eric5512/FreeEEG/Electronics/bom.xls

JLCPCB BOM Tool - BOM Matching
BOM name：bom-JLCPCB Assembly Order.xlsx |  |  | Download Time：2026-04-22 14:54:59 |  |  |  | * Our matching results are updated in real-time, but stock and prices may change. If it's been over 24 hours, please re-match before placing your order.
PCB Assembled Qty：5 |  |  | Est. Total Price：171.8839
Your BOM |  |  |  |  | Matched Parts |  |  |  |  |  |  | Order Information
Top Designator | Bottom Designator | Comment | Footprint | JLCPCB Part # | Matches | Part # | Manufacturer | Footprint | Description | Category | Warning | JLCPCB Part # | Product link | Lib Type | Qty | Source | Total Price ($)
C1,C31,C5 |  | 10u | 0805 |  | Select by System | GRM21BR61H106KE43L | Murata Electronics | 0805 | 10uF 50V X5R ±10% 0805 Multilayer Ceramic Capacitors MLCC - SMD/SMT ROHS | Multilayer Ceramic Capacitors MLCC - SMD/SMT |  | C440198 | https://jlcpcb.com/partdetail/439567-GRM21BR61H106KE43L/C440198 | Basic | 10 | 10 JLCPCB | 0.681
C2 |  | 10n | 0805 |  | Select by System | CL21B103KBANNNC | Samsung Electro-Mechanics | 0805 | 10nF 50V X7R ±10% 0805 Multilayer Ceramic Capacitors MLCC - SMD/SMT ROHS | Multilayer Ceramic Capacitors MLCC - SMD/SMT |  | C1710 | https://jlcpcb.com/partdetail/2062-CL21B103KBANNNC/C1710 | Basic | 20 | 20 JLCPCB | 0.132
C4 |  | 100n | 0805 |  | Select by System | CC0805KRX7R9BB104 | YAGEO | 0805 | 100nF 50V X7R ±10% 0805 Multilayer Ceramic Capacitors MLCC - SMD/SMT ROHS | Multilayer Ceramic Capacitors MLCC - SMD/SMT |  | C49678 | https://jlcpcb.com/partdetail/YAGEO-CC0805KRX7R9BB104/C49678 | Basic | 20 | 20 JLCPCB | 0.1
C6 |  | 330u | SMD |  | Select by System | EEEFT1V331AP | PANASONIC | SMD | -55℃~+105℃ 2000hrs@105℃ 330uF 35V 80mΩ@100kHz 850mA@100kHz ±20% SMD Aluminum Electrolytic Capacitors - SMD ROHS | Aluminum Electrolytic Capacitors - SMD |  | C178598 | https://jlcpcb.com/partdetail/PANASONIC-EEEFT1V331AP/C178598 | Extended | 5 | 5 JLCPCB | 2.597
C7 |  | 470u | SMD |  | Select by System | EEEFT1E471GP | PANASONIC | SMD | -55℃~+105℃ 25V 470uF 5000hrs@105℃ 80mΩ@100kHz 850mA@100kHz ±20% SMD Aluminum Electrolytic Capacitors - SMD ROHS | Aluminum Electrolytic Capacitors - SMD |  | C193277 | https://jlcpcb.com/partdetail/PANASONIC-EEEFT1E471GP/C193277 | Extended | 2 | 2 JLCPCB | 1.2656
C10,C11,C12,C13,C14,C15,C16,C17,C18,C19,C20,C21,C22,C23,C24,C8,C9 |  | 4.7n | 0603 |  | Select by System | GRM1885C1H472JA01D | Murata Electronics | 0603 | 4.7nF 50V C0G ±5% 0603 Multilayer Ceramic Capacitors MLCC - SMD/SMT ROHS | Multilayer Ceramic Capacitors MLCC - SMD/SMT |  | C85980 | https://jlcpcb.com/partdetail/MurataElectronics-GRM1885C1H472JA01D/C85980 | Extended | 44 | 44 JLCPCB | 0.594
C25,C26,C27,C3 |  | 1u | 0805 |  | Select by System | CL21B105KBFNNNE | Samsung Electro-Mechanics | 0805 | 1uF 50V X7R ±10% 0805 Multilayer Ceramic Capacitors MLCC - SMD/SMT ROHS | Multilayer Ceramic Capacitors MLCC - SMD/SMT |  | C28323 | https://jlcpcb.com/partdetail/29074-CL21B105KBFNNNE/C28323 | Basic | 20 | 20 JLCPCB | 0.266
C28,C29 |  | 33u | 1206 |  | Select by System | C3216X5R1E336MT000E | TDK | 1206 | 25V 33uF X5R ±20% 1206 Multilayer Ceramic Capacitors MLCC - SMD/SMT ROHS | Multilayer Ceramic Capacitors MLCC - SMD/SMT |  | C342307 | https://jlcpcb.com/partdetail/TDK-C3216X5R1E336MT000E/C342307 | Extended | 4 | 4 JLCPCB | 2.1988
C30,C46 |  | 10n | 0603 |  | Select by System | 0603B103K500NT | FH (Guangdong Fenghua Advanced Tech) | 0603 | 10nF 50V X7R ±10% 0603 Multilayer Ceramic Capacitors MLCC - SMD/SMT ROHS | Multilayer Ceramic Capacitors MLCC - SMD/SMT |  | C57112 | https://jlcpcb.com/partdetail/58143-0603B103K500NT/C57112 | Basic | 20 | 20 JLCPCB | 0.06
C32,C36,C39,C41,C43,C45 |  | 0.1u | 0603 |  | Unconfirmed | CC0603KRX7R9BB104 | YAGEO | 0603 | 100nF 50V X7R ±10% 0603 Multilayer Ceramic Capacitors MLCC - SMD/SMT ROHS | Multilayer Ceramic Capacitors MLCC - SMD/SMT | 1.Multiple lines in the BOM have been matched to the same part. Please check if the matching is correct. ; | C14663 | https://jlcpcb.com/partdetail/YAGEO-CC0603KRX7R9BB104/C14663 | Basic | 24 | 24 JLCPCB | 0.0792
C47 |  | 100n | 0603 |  | Unconfirmed | CC0603KRX7R9BB104 | YAGEO | 0603 | 100nF 50V X7R ±10% 0603 Multilayer Ceramic Capacitors MLCC - SMD/SMT ROHS | Multilayer Ceramic Capacitors MLCC - SMD/SMT | 1.Multiple lines in the BOM have been matched to the same part. Please check if the matching is correct. ; | C14663 | https://jlcpcb.com/partdetail/YAGEO-CC0603KRX7R9BB104/C14663 | Basic | 24 | 24 JLCPCB | 0.0792
C33 |  | 100u | SMD,D6.3xL7.7mm |  | Select by System | RVT1V101M0607 | Honor Elec | SMD,D6.3xL7.7mm | -55℃~+105℃ 100uF 2000hrs@105℃ 35V 6.3mm 7.7mm ±20% SMD,D6.3xL7.7mm Aluminum Electrolytic Capacitors - SMD ROHS | Aluminum Electrolytic Capacitors - SMD |  | C3339 | https://jlcpcb.com/partdetail/HonorElec-RVT1V101M0607/C3339 | Extended | 5 | 5 JLCPCB | 0.188
C34,C35,C37,C38,C40,C42,C44 |  | 1u | 0603 |  | Select by System | CL10A105KB8NNNC | Samsung Electro-Mechanics | 0603 | 1uF 50V X5R ±10% 0603 Multilayer Ceramic Capacitors MLCC - SMD/SMT ROHS | Multilayer Ceramic Capacitors MLCC - SMD/SMT |  | C15849 | https://jlcpcb.com/partdetail/16531-CL10A105KB8NNNC/C15849 | Basic | 24 | 24 JLCPCB | 0.1872
C48 |  | 2.2n | 0603 |  | Select by System | 0603B222K500NT | FH (Guangdong Fenghua Advanced Tech) | 0603 | 2.2nF 50V X7R ±10% 0603 Multilayer Ceramic Capacitors MLCC - SMD/SMT ROHS | Multilayer Ceramic Capacitors MLCC - SMD/SMT |  | C1604 | https://jlcpcb.com/partdetail/1956-0603B222K500NT/C1604 | Basic | 20 | 20 JLCPCB | 0.062
D1 |  | ON_LED | 0805 |  | Select by System | NCD0805R1 | Foshan NationStar Optoelectronics | 0805 | -30℃~+85℃ 1.6V~2.6V 130° 195mcd 25mA 615nm~630nm 630nm 65mW Discrete Diode Red 0805 LED Indication - Discrete ROHS | LED Indication - Discrete |  | C84256 | https://jlcpcb.com/partdetail/85425-NCD0805R1/C84256 | Basic | 20 | 20 JLCPCB | 0.266
D2 |  | SS54B | SMB |  | Select by System | SS54B | hongjiacheng | SMB | -55℃~+125℃ 120A 200uA@40V 40V 550mV@5A 5A Independent SMB Schottky Diodes ROHS | Schottky Diodes |  | C18199181 | https://jlcpcb.com/partdetail/hongjiacheng-SS54B/C18199181 | Extended | 5 | 5 JLCPCB | 0.328
D3 |  | LED_RAGB | SMD3528-4P |  | Select by System | XL-3528RGBW-HM | XINGLIGHT | SMD3528-4P | -20℃~+85℃ 1.9mm 120° 2.8mm 3.5mm B:460nm~475nm、G:515nm~530nm、R:620nm~630nm Common Anode G:400mcd~600mcd、B:120mcd~180mcd、R:150mcd~200mcd R:1.8V~2.2V、G:2.9V~3.2V、B:3.0V~3.3V R:2000V、G:2000V、B:2000V R:20mA、G:20mA、B:20mA R:50mW、G:70mW、B:70mW R:625nm、B:465nm、G:525nm Top-mount SMD3528-4P RGB LEDs ROHS | RGB LEDs |  | C2843813 | https://jlcpcb.com/partdetail/XINGLIGHT-XL_3528RGBWHM/C2843813 | Extended | 10 | 10 JLCPCB | 0.344
J2 |  | 10137065-00021LF | SMD |  | Select by System | 10137065-00021LF | Amphenol ICC | SMD | -55℃~+85℃ 1 24P Black Female Surface Mount, Right Angle Type-C SMD USB Connectors ROHS | Others |  | C5417177 | https://jlcpcb.com/partdetail/AmphenolICC-1013706500021LF/C5417177 | Extended | 2 | 2 JLCPCB | 7.456
L1 |  | 47u | SMD |  | Select by Customer | CYA0650-47UH | SHOU HAN | SMD,7.2x6.6mm | 2.8A 250mΩ 2A 47uH ±20% SMD,7.2x6.6mm Inductors (SMD) ROHS | Inductors (SMD) |  | C5189938 | https://jlcpcb.com/partdetail/SHOUHAN-CYA065047UH/C5189938 | Extended | 5 | 5 JLCPCB | 1.455
MICRO_SD1 |  | TF-01A | SMD |  | Select by System | TF-01A | Korean Hroparts Elec | SMD | 1.85mm Connector and Ejector MicroSD Card (TF Card) Push-Push With Locating Pins SMD SD Card / Memory Card Connector ROHS | SD Card / Memory Card Connector |  | C91145 | https://jlcpcb.com/partdetail/Korean_HropartsElec-TF01A/C91145 | Extended | 2 | 2 JLCPCB | 0.3772
Q1,Q2,Q3 |  | 2N7002 | SOT-23 |  | Select by System | 2N7002 | Jiangsu Changjing Electronics Technology Co., Ltd. | SOT-23 | 1 N-channel 115mA 2.5V 225mW 50pF 5pF 5Ω@10V 60V SOT-23 MOSFETs ROHS | MOSFETs |  | C8545 | https://jlcpcb.com/partdetail/9040-2N7002/C8545 | Basic | 11 | 11 JLCPCB | 0.1463
R1,R12,R13,R2,R3,R35,R4,R45,R5 |  | 10k | 0603 |  | Select by System | 0603WAF1002T5E | UNI-ROYAL(Uniroyal Elec) | 0603 | -55℃~+155℃ 100mW 10kΩ 75V Thick Film Resistor ±1% ±100ppm/℃ 0603 Chip Resistor - Surface Mount ROHS | Chip Resistor - Surface Mount |  | C25804 | https://jlcpcb.com/partdetail/26547-0603WAF1002T5E/C25804 | Basic | 28 | 28 JLCPCB | 0.0392
R6,R7 |  | 5.1k | 0603 |  | Select by System | 0603WAF5101T5E | UNI-ROYAL(Uniroyal Elec) | 0603 | -55℃~+155℃ 100mW 5.1kΩ 75V Thick Film Resistor ±1% ±100ppm/℃ 0603 Chip Resistor - Surface Mount ROHS | Chip Resistor - Surface Mount |  | C23186 | https://jlcpcb.com/partdetail/23913-0603WAF5101T5E/C23186 | Basic | 20 | 20 JLCPCB | 0.032
R10,R11,R34,R8,R9 |  | 33k | 0603 |  | Select by System | 0603WAF3302T5E | UNI-ROYAL(Uniroyal Elec) | 0603 | -55℃~+155℃ 100mW 33kΩ 75V Thick Film Resistor ±1% ±100ppm/℃ 0603 Chip Resistor - Surface Mount ROHS | Chip Resistor - Surface Mount |  | C4216 | https://jlcpcb.com/partdetail/4623-0603WAF3302T5E/C4216 | Basic | 20 | 20 JLCPCB | 0.028
R14 |  | 400 | 0805 |  | Select by System | TR0805B400RP0525Z | Ever Ohms Tech | 0805 | -55℃~+155℃ 125mW 150V 400Ω Thin Film Resistor ±0.1% ±25ppm/℃ 0805 Chip Resistor - Surface Mount ROHS | Chip Resistor - Surface Mount |  | C153298 | https://jlcpcb.com/partdetail/Ever_OhmsTech-TR0805B400RP0525Z/C153298 | Extended | 20 | 20 JLCPCB | 0.636
R15,R16,R17,R18,R19,R20,R21,R22,R23,R24,R25,R26,R27,R28,R29,R30,R31,R46 |  | 4.99k | 0603 |  | Select by System | 0603WAF4991T5E | UNI-ROYAL(Uniroyal Elec) | 0603 | -55℃~+155℃ 100mW 4.99kΩ 75V Thick Film Resistor ±1% ±100ppm/℃ 0603 Chip Resistor - Surface Mount ROHS | Chip Resistor - Surface Mount |  | C23046 | https://jlcpcb.com/partdetail/23773-0603WAF4991T5E/C23046 | Basic | 46 | 46 JLCPCB | 0.0782
R32,R33,R37 |  | 2M | 0603 |  | Select by System | 0603WAF2004T5E | UNI-ROYAL(Uniroyal Elec) | 0603 | -55℃~+155℃ 100mW 2MΩ 75V Thick Film Resistor ±1% ±100ppm/℃ 0603 Chip Resistor - Surface Mount ROHS | Chip Resistor - Surface Mount |  | C22976 | https://jlcpcb.com/partdetail/23703-0603WAF2004T5E/C22976 | Basic | 20 | 20 JLCPCB | 0.034
R36 |  | 392k | 0603 |  | Select by System | RCA03392KFLF | HKR(Hong Kong Resistors) | 0603 | -55℃~+155℃ 100mW 392kΩ 75V Thick Film Resistor ±1% ±100ppm/℃ 0603 Chip Resistor - Surface Mount ROHS |  |  | C22369707 | https://jlcpcb.com/partdetail/23848738-RCA03392KFLF/C22369707 | Extended | 20 | 20 JLCPCB | 0.018
R38 |  | 1M | 0603 |  | Select by System | 0603WAF1004T5E | UNI-ROYAL(Uniroyal Elec) | 0603 | -55℃~+155℃ 100mW 1MΩ 75V Thick Film Resistor ±1% ±100ppm/℃ 0603 Chip Resistor - Surface Mount ROHS | Chip Resistor - Surface Mount |  | C22935 | https://jlcpcb.com/partdetail/23662-0603WAF1004T5E/C22935 | Basic | 20 | 20 JLCPCB | 0.03
R39 |  | 720 | 0805 |  | Select by System | 0805W8F7320T5E | UNI-ROYAL(Uniroyal Elec) | 0805 | -55℃~+155℃ 125mW 150V 732Ω Thick Film Resistor ±1% ±100ppm/℃ 0805 Chip Resistor - Surface Mount ROHS | Chip Resistor - Surface Mount |  | C37998 | https://jlcpcb.com/partdetail/38979-0805W8F7320T5E/C37998 | Extended | 20 | 20 JLCPCB | 0.042
R40,R41 |  | 610 | 0805 |  | Select by System | FRC0805F5900TS | FOJAN | 0805 | -55℃~+155℃ 125mW 150V 590Ω Thick Film Resistor ±1% ±100ppm/℃ 0805 Chip Resistor - Surface Mount ROHS | Chip Resistor - Surface Mount |  | C5713312 | https://jlcpcb.com/partdetail/FOJAN-FRC0805F5900TS/C5713312 | Extended | 20 | 20 JLCPCB | 0.038
R42,R43,R44 |  | 10 | 0603 |  | Select by System | 0603WAF100JT5E | UNI-ROYAL(Uniroyal Elec) | 0603 | -55℃~+155℃ 100mW 10Ω 75V Thick Film Resistor ±1% ±400ppm/℃ 0603 Chip Resistor - Surface Mount ROHS | Chip Resistor - Surface Mount |  | C22859 | https://jlcpcb.com/partdetail/23586-0603WAF100JT5E/C22859 | Basic | 20 | 20 JLCPCB | 0.038
SW1 |  | ON_SW | 插件,9x3.5mm |  | Unconfirmed | K3-1260D-L1 | Korean Hroparts Elec | 插件,9x3.5mm | -25℃~+80℃ 10000 times 3.5mm 3.5mm 300mA 6V 9mm Black PC Pin Rectangular Columnar SPDT 插件,9x3.5mm Slide Switches ROHS | Slide Switches | 1.Multiple lines in the BOM have been matched to the same part. Please check if the matching is correct. ; | C92657 | https://jlcpcb.com/partdetail/Korean_HropartsElec-K3_1260DL1/C92657 | Extended | 5 | 5 JLCPCB | 0.7715
SW2 |  | SEL_SW | 插件,9x3.5mm |  | Unconfirmed | K3-1260D-L1 | Korean Hroparts Elec | 插件,9x3.5mm | -25℃~+80℃ 10000 times 3.5mm 3.5mm 300mA 6V 9mm Black PC Pin Rectangular Columnar SPDT 插件,9x3.5mm Slide Switches ROHS | Slide Switches | 1.Multiple lines in the BOM have been matched to the same part. Please check if the matching is correct. ; | C92657 | https://jlcpcb.com/partdetail/Korean_HropartsElec-K3_1260DL1/C92657 | Extended | 5 | 5 JLCPCB | 0.7715
SW3 |  | RST_BTN | SMD-4P,5.2x5.2mm |  | Unconfirmed | K2-1187SQ-A4SW-06 | Korean Hroparts Elec | SMD-4P,5.2x5.2mm | -25℃~+85℃ 1.5mm 100,000 cycles 12V 2.5N 5.2mm 5.2mm 50mA Round Button SPST Surface Mount,Vertical SMD-4P,5.2x5.2mm Tactile Switches ROHS | Tactile Switches | 1.Multiple lines in the BOM have been matched to the same part. Please check if the matching is correct. ; | C92584 | https://jlcpcb.com/partdetail/Korean_HropartsElec-K2_1187SQ_A4SW06/C92584 | Extended | 4 | 4 JLCPCB | 0.2144
SW4 |  | BOOT_BTN | SMD-4P,5.2x5.2mm |  | Unconfirmed | K2-1187SQ-A4SW-06 | Korean Hroparts Elec | SMD-4P,5.2x5.2mm | -25℃~+85℃ 1.5mm 100,000 cycles 12V 2.5N 5.2mm 5.2mm 50mA Round Button SPST Surface Mount,Vertical SMD-4P,5.2x5.2mm Tactile Switches ROHS | Tactile Switches | 1.Multiple lines in the BOM have been matched to the same part. Please check if the matching is correct. ; | C92584 | https://jlcpcb.com/partdetail/Korean_HropartsElec-K2_1187SQ_A4SW06/C92584 | Extended | 4 | 4 JLCPCB | 0.2144
U1 |  | ADS1299 | TQFP-64(10x10) |  | Select by System | ADS1299IPAGR | Texas Instruments | TQFP-64(10x10) | -40℃~+85℃ 1.5MHz~2.048MHz、2.048MHz 121dB 16000Hz 16000Hz 20uA 24 35ppm/℃ 3ppm/℃ 4.5V 4.75V~5.25V SPI TQFP-64(10x10) Analog Front End (AFE) ROHS | Analog Front End (AFE) |  | C476817 | https://jlcpcb.com/partdetail/TexasInstruments-ADS1299IPAGR/C476817 | Extended | 2 | 2 JLCPCB | 115.9016
U2,U4 |  | OPA376xxDBV | SOT-23-5 |  | Select by System | OPA376AIDBVR | Texas Instruments | SOT-23-5 | -40℃~+125℃ 0.2pA 0.2pA 1 2.2V~5.5V 260nV/℃ 2V/us 30mA 5.5MHz 5uV 7.5nV/√Hz@1kHz 760uA 76dB Rail-to-Rail Input, Rail-to-Rail Output SOT-23-5 Precision Op Amps ROHS | Precision Op Amps |  | C42134 | https://jlcpcb.com/partdetail/TexasInstruments-OPA376AIDBVR/C42134 | Extended | 4 | 4 JLCPCB | 2.442
U3 |  | ESP32-S3-WROOM-1 | SMD,25.5x18mm |  | Select by System | ESP32-S3-WROOM-1-N16R8 | Espressif Systems | SMD,25.5x18mm | -103.5dBm -40℃~+65℃ 2.4GHz 20.5dBm 355mA 3V~3.6V 95mA ESP32-S3R8 On-board PCB Antenna UART、SPI、I2C、GPIO、I2S、USB SMD,25.5x18mm WiFi Modules ROHS | WiFi Modules |  | C2913202 | https://jlcpcb.com/partdetail/3198300-ESP32_S3_WROOM_1N16R8/C2913202 | Extended | 2 | 2 JLCPCB | 10.2492
U5 |  | XL1509-3.3 | SOP-8 |  | Select by System | XL1509-3.3 | UMW(Youtai Semiconductor Co., Ltd.) | SOP-8 | -40℃~+125℃@(TJ) 1 150kHz 2A 2mA 3.3V 4.5V~40V Buck Buck Built-in Fixed No SOP-8 DC-DC Converters ROHS | DC-DC Converters |  | C2681226 | https://jlcpcb.com/partdetail/2773702-XL1509_33/C2681226 | Extended | 2 | 2 JLCPCB | 0.5102
U6 |  | NCP1117-5.0_SOT223 | SOT-223 |  | Select by System | NCP1117IST50T3G | onsemi | SOT-223 | -40℃~+125℃@(Ta) 0.003%Vout 1 1.2V@(800mA) 1A 20V 5V 61dB@(120Hz) 6mA Fixed Over Current Protection、Over Temperature Protection、Thermal Shutdown Positive SOT-223 Voltage Regulators - Linear, Low Drop Out (LDO) Regulators ROHS | Voltage Regulators - Linear, Low Drop Out (LDO) Regulators |  | C2902120 | https://jlcpcb.com/partdetail/onsemi-NCP1117IST50T3G/C2902120 | Extended | 2 | 2 JLCPCB | 1.1506
U7 |  | MPU-6050 | QFN-24-EP(4x4) |  | Select by System | MPU-6050 | TDK InvenSense | QFN-24-EP(4x4) | -40℃~+85℃ 16bit 1KB 2.375V~3.46V 5uA Accelerometer Gyroscope I2C X,Y,Z X,Y,Z ±16g ±2000dps QFN-24-EP(4x4) Accelerometers ROHS | Accelerometers |  | C24112 | https://jlcpcb.com/partdetail/TDKInvenSense-MPU6050/C24112 | Extended | 2 | 2 JLCPCB | 19.7826
BT1 |  | 9V |  |  | No matches | No Part Selected
J1 |  | ConnElectrodes |  |  | No matches | No Part Selected
