eric5512/FreeEEG/electronics/production/bom-JLCPCB Assembly Order.xls

JLCPCB BOM Tool - BOM Matching
BOM name：bom-JLCPCB Assembly Order.xlsx |  |  | Download Time：2026-07-23 12:50:30 |  |  |  | * Our matching results are updated in real-time, but stock and prices may change. If it's been over 24 hours, please re-match before placing your order.
PCB Assembled Qty：5 |  |  | Est. Total Price：168.9733
Your BOM |  |  |  |  | Matched Parts |  |  |  |  |  |  | Order Information
Top Designator | Bottom Designator | Comment | Footprint | JLCPCB Part # | Matches | Part # | Manufacturer | Footprint | Description | Category | Warning | JLCPCB Part # | Product link | Lib Type | Qty | Source | Total Price ($)
C1,C5 | C31 | 10u | 0805 |  | Unconfirmed | GRM21BR61H106KE43L | Murata Electronics | 0805 | 10uF 50V X5R ±10% 0805 Multilayer Ceramic Capacitors MLCC - SMD/SMT ROHS | Multilayer Ceramic Capacitors MLCC - SMD/SMT | 1.The comment (GRM21BR61H106KE43L) of this part does not match the one (10u) provided in your BOM. Please confirm; | C440198 | https://jlcpcb.com/partdetail/439567-GRM21BR61H106KE43L/C440198 | Basic | 10 | 10 JLCPCB | 2.825
C2 |  | 10n | 0805 |  | Unconfirmed | CL21B103KBANNNC | Samsung Electro-Mechanics | 0805 | 10nF 50V X7R ±10% 0805 Multilayer Ceramic Capacitors MLCC - SMD/SMT ROHS | Multilayer Ceramic Capacitors MLCC - SMD/SMT | 1.The comment (CL21B103KBANNNC) of this part does not match the one (10n) provided in your BOM. Please confirm; | C1710 | https://jlcpcb.com/partdetail/2062-CL21B103KBANNNC/C1710 | Basic | 20 | 20 JLCPCB | 0.378
C4 |  | 100n | 0805 |  | Unconfirmed | CC0805KRX7R9BB104 | YAGEO | 0805 | 100nF 50V X7R ±10% 0805 Multilayer Ceramic Capacitors MLCC - SMD/SMT ROHS | Multilayer Ceramic Capacitors MLCC - SMD/SMT | 1.The comment (CC0805KRX7R9BB104) of this part does not match the one (100n) provided in your BOM. Please confirm; | C49678 | https://jlcpcb.com/partdetail/YAGEO-CC0805KRX7R9BB104/C49678 | Basic | 20 | 20 JLCPCB | 0.642
 | C24 | 4.7n | 0603 |  | Unconfirmed | 0603B472K500NT | FH (Guangdong Fenghua Advanced Tech) | 0603 | 4.7nF 50V X7R ±10% 0603 Multilayer Ceramic Capacitors MLCC - SMD/SMT ROHS | Multilayer Ceramic Capacitors MLCC - SMD/SMT | 1.The comment (0603B472K500NT) of this part does not match the one (4.7n) provided in your BOM. Please confirm; | C53987 | https://jlcpcb.com/partdetail/55004-0603B472K500NT/C53987 | Basic | 20 | 20 JLCPCB | 0.43
C26,C52 |  | 1u | 0402 |  | Unconfirmed | CL05A105KA5NQNC | Samsung Electro-Mechanics | 0402 | 1uF 25V X5R ±10% 0402 Multilayer Ceramic Capacitors MLCC - SMD/SMT ROHS | Multilayer Ceramic Capacitors MLCC - SMD/SMT | 1.The comment (CL05A105KA5NQNC) of this part does not match the one (1u) provided in your BOM. Please confirm; | C52923 | https://jlcpcb.com/partdetail/53938-CL05A105KA5NQNC/C52923 | Basic | 20 | 20 JLCPCB | 0.53
C27,C3 | C25 | 1u | 0805 |  | Unconfirmed | CL21B105KBFNNNE | Samsung Electro-Mechanics | 0805 | 1uF 50V X7R ±10% 0805 Multilayer Ceramic Capacitors MLCC - SMD/SMT ROHS | Multilayer Ceramic Capacitors MLCC - SMD/SMT | 1.The comment (CL21B105KBFNNNE) of this part does not match the one (1u) provided in your BOM. Please confirm; | C28323 | https://jlcpcb.com/partdetail/29074-CL21B105KBFNNNE/C28323 | Basic | 40 | 40 JLCPCB | 3.456
C28,C50,C51,C6,C7 |  | 10u | 0402 |  | Unconfirmed | CL05A106MQ5NUNC | Samsung Electro-Mechanics | 0402 | 10uF 6.3V X5R ±20% 0402 Multilayer Ceramic Capacitors MLCC - SMD/SMT ROHS | Multilayer Ceramic Capacitors MLCC - SMD/SMT | 1.The comment (CL05A106MQ5NUNC) of this part does not match the one (10u) provided in your BOM. Please confirm; | C15525 | https://jlcpcb.com/partdetail/16204-CL05A106MQ5NUNC/C15525 | Basic | 20 | 20 JLCPCB | 0.814
C29 |  | 4.7u | 0402 |  | Select by Customer | 0402C0G560J500NT | AIDE CAPACITOR | 0402 | 0402 Multilayer Ceramic Capacitors MLCC - SMD/SMT ROHS | Multilayer Ceramic Capacitors MLCC - SMD/SMT | 1.The comment (0402C0G560J500NT) of this part does not match the one (4.7u) provided in your BOM. Please confirm; | C48579244 | https://jlcpcb.com/partdetail/AIDECAPACITOR-0402C0G560J500NT/C48579244 | Extended | 20 | 20 JLCPCB | 0.028
 | C32,C36,C39,C41,C43,C45 | 0.1u | 0603 |  | Unconfirmed | CC0603KRX7R9BB104 | YAGEO | 0603 | 100nF 50V X7R ±10% 0603 Multilayer Ceramic Capacitors MLCC - SMD/SMT ROHS | Multilayer Ceramic Capacitors MLCC - SMD/SMT | 1.The comment (CC0603KRX7R9BB104) of this part does not match the one (0.1u) provided in your BOM. Please confirm; | C14663 | https://jlcpcb.com/partdetail/YAGEO-CC0603KRX7R9BB104/C14663 | Basic | 22 | 22 JLCPCB | 0.55
 | C33 | 100u | 1206 |  | Unconfirmed | CL31A107MQHNNNE | Samsung Electro-Mechanics | 1206 | 100uF 6.3V X5R ±20% 1206 Multilayer Ceramic Capacitors MLCC - SMD/SMT ROHS | Multilayer Ceramic Capacitors MLCC - SMD/SMT | 1.The comment (CL31A107MQHNNNE) of this part does not match the one (100u) provided in your BOM. Please confirm; | C15008 | https://jlcpcb.com/partdetail/15681-CL31A107MQHNNNE/C15008 | Basic | 6 | 6 JLCPCB | 1.761
C46,C47,C48 | C30 | 10n | 0603 |  | Unconfirmed | 0603B103K500NT | FH (Guangdong Fenghua Advanced Tech) | 0603 | 10nF 50V X7R ±10% 0603 Multilayer Ceramic Capacitors MLCC - SMD/SMT ROHS | Multilayer Ceramic Capacitors MLCC - SMD/SMT | 1.The comment (0603B103K500NT) of this part does not match the one (10n) provided in your BOM. Please confirm; | C57112 | https://jlcpcb.com/partdetail/58143-0603B103K500NT/C57112 | Basic | 40 | 40 JLCPCB | 0.136
C49 | C34,C35,C37,C38,C40,C42,C44 | 1u | 0603 |  | Unconfirmed | CL10A105KB8NNNC | Samsung Electro-Mechanics | 0603 | 1uF 50V X5R ±10% 0603 Multilayer Ceramic Capacitors MLCC - SMD/SMT ROHS | Multilayer Ceramic Capacitors MLCC - SMD/SMT | 1.The comment (CL10A105KB8NNNC) of this part does not match the one (1u) provided in your BOM. Please confirm; | C15849 | https://jlcpcb.com/partdetail/16531-CL10A105KB8NNNC/C15849 | Basic | 44 | 44 JLCPCB | 1.0428
D1 |  | LED_AMBAR | 0603 |  | Unconfirmed | XL-1608SURC-06 | XINGLIGHT | 0603 | -40℃~+85℃ 120° 2.3V 20mA 225mcd 50mW 620nm~630nm 625nm Discrete Diode Red Top-mount Water Clear 0603 LED Indication - Discrete ROHS | LED Indication - Discrete | 1.The comment (XL-1608SURC-06) of this part does not match the one (LED_AMBAR) provided in your BOM. Please confirm; | C965799 | https://jlcpcb.com/partdetail/XINGLIGHT-XL_1608SURC06/C965799 | Extended | 20 | 20 JLCPCB | 0.076
D2 |  | LED_BLUE | 0603 |  | Select by System | XL-1608UBC-04 | XINGLIGHT | 0603 | -40℃~+85℃ 120° 20mA 3.3V 300mcd 455nm~475nm 470nm 70mW Blue Discrete Diode Top-mount Water Clear 0603 LED Indication - Discrete ROHS | LED Indication - Discrete |  | C965807 | https://jlcpcb.com/partdetail/XINGLIGHT-XL_1608UBC04/C965807 | Extended | 20 | 20 JLCPCB | 0.086
D3 |  | WS2812B | LED_WS2812B_PLCC4_5.0x5.0mm_P3.2mm |  | Select by Customer | WS2812B-V5/W | Worldsemi | SMD5050-4P | -40℃~+65℃ 0.6mA 1.57mm 2kHz 5.4mm 5V 5mm 800Kbit/s B:465nm~475nm、R:620nm~630nm、G:515nm~525nm Built-in power-on reset circuit、Built-in power-on reset circuit、Integrated intelligent reverse connection protection function R:310mcd、G:780mcd、B:215mcd White Frosted Lens SMD5050-4P RGB LEDs(Built-in IC) ROHS | RGB LEDs(Built-In IC) | 1.The comment (WS2812B-V5/W) of this part does not match the one (WS2812B) provided in your BOM. Please confirm; | C2874885 | https://jlcpcb.com/partdetail/Worldsemi-WS2812B_V5W/C2874885 | Extended | 5 | 5 JLCPCB | 0.544
IC1 |  | ICM-42670-P | ICM42670P |  | Select by System | ICM-42670-P | TDK InvenSense | LGA-14(2.5x3) | -40℃~+85℃ 1.71V~3.6V 16bit 2.25KB 3.5uA Accelerometer Gyroscope SPI、I2C、I3C X,Y,Z X,Y,Z ±16g ±2000dps LGA-14(2.5x3) Accelerometers ROHS | Accelerometers |  | C3288646 | https://jlcpcb.com/partdetail/TDKInvenSense-ICM_42670P/C3288646 | Extended | 2 | 2 JLCPCB | 6.2906
IC2 |  | BQ25185DLHR | SON40P220X200X80-11N |  | Select by System | BQ25185DLHR | Texas Instruments | WSON-10-EP(2.2x2) | -40℃~+125℃ 1 1A 2.2V 3V~18V 4.4V 4uA Charging IC Lithium Battery、LiFePO4 Battery Support WSON-10-EP(2.2x2) Battery Management ROHS | Battery Management |  | C19725033 | https://jlcpcb.com/partdetail/TexasInstruments-BQ25185DLHR/C19725033 | Extended | 2 | 2 JLCPCB | 3.2228
J2 |  | 10137065-00021LF | AMPHENOL_10137065-00021LF |  | Select by System | 10137065-00021LF | Amphenol ICC | SMD | -55℃~+85℃ 1 24P Black Female Surface Mount, Right Angle Type-C SMD USB Connectors ROHS | Others |  | C5417177 | https://jlcpcb.com/partdetail/AmphenolICC-1013706500021LF/C5417177 | Extended | 2 | 2 JLCPCB | 6.9448
J5 |  | B2B-PH-SM4-TBT_LF | B2BPHSM4TBTLFSN |  | Select by Customer | B2B-PH-SM4-TBT(LF)(SN) | JST | SMD,P=2mm | -25℃~+85℃ 1 100V 1x2P 2 2A 2P 2mm 6.6mm 7.95mm 7mm Auxiliary Solder Pin Beige Copper alloy PA PH Surface Mount,Vertical Tin UL94V-0 SMD,P=2mm Wire To Board Connector ROHS | Wire To Board Connector |  | C265003 | https://jlcpcb.com/partdetail/JST-B2B_PH_SM4_TBT_LF_SN/C265003 | Extended | 5 | 5 JLCPCB | 2.264
J6 |  | ExtTrig | PinHeader_2x03_P2.54mm_Vertical_SMD |  | Select by Customer | 2.54-2*3P立贴针 | BOOMELE(Boom Precision Elec) | SMD,P=2.54mm,卧贴 | -55℃~+105℃ 2 2.54mm 2.54mm 2.5mm 3A 6P 6mm Black Brass Gold Pin Header Surface Mount,Vertical SMD,P=2.54mm,卧贴 Pin Headers ROHS | Pin Headers |  | C192301 | https://jlcpcb.com/partdetail/221272-2_54_2_3P/C192301 | Extended | 10 | 10 JLCPCB | 0.477
L1 |  | 1u | 1008 |  | Select by Customer | MLP2520S1R0MT0S1 | TDK | 1008 | 1.5A 1uH 85mΩ Multilayer inductor ±20% 1008 Inductors (SMD) ROHS | Inductors (SMD) |  | C76795 | https://jlcpcb.com/partdetail/TDK-MLP2520S1R0MT0S1/C76795 | Extended | 6 | 6 JLCPCB | 0.5718
L2 |  | 2.2u | PIS2D18LP |  | Select by Customer | PIS2D18LP-2R2M-T | EMTEK | SMD | 2.2uH 55mΩ 750mA Magnetic Shielded Inductor ±20% SMD Power Inductors ROHS | Power Inductors |  | C251730 | https://jlcpcb.com/partdetail/EMTEK-PIS2D18LP_2R2MT/C251730 | Extended | 5 | 5 JLCPCB | 1.1815
MICRO_SD1 |  | TF-01A | TF-01A |  | Select by System | TF-01A | Korean Hroparts Elec | SMD | 1.85mm Connector and Ejector MicroSD Card (TF Card) Push-Push With Locating Pins SMD SD Card / Memory Card Connector ROHS | SD Card / Memory Card Connector |  | C91145 | https://jlcpcb.com/partdetail/Korean_HropartsElec-TF01A/C91145 | Extended | 2 | 2 JLCPCB | 0.3804
MK1 |  | ICS-43434 | ICS43434 |  | Select by System | ICS-43434 | TDK InvenSense | LGA-6(3.5x2.7) | -26dB -40℃~+85℃ 0.98mm 1.65V~3.63V 2.65mm 3.5mm 550uA 64dB I2S Omnidirectional Omnidirectional pickup LGA-6(3.5x2.7) MEMS Microphones ROHS | MEMS Microphones |  | C5656610 | https://jlcpcb.com/partdetail/TDKInvenSense-ICS43434/C5656610 | Extended | 2 | 2 JLCPCB | 9.22
R1,R15,R2,R3,R35,R4,R40,R5 | R12,R13,R45 | 10k | 0603 |  | Unconfirmed | 0603WAF1002T5E | UNI-ROYAL(Uniroyal Elec) | 0603 | -55℃~+155℃ 100mW 10kΩ 75V Thick Film Resistor ±1% ±100ppm/℃ 0603 Chip Resistor - Surface Mount ROHS | Chip Resistor - Surface Mount | 1.The comment (0603WAF1002T5E) of this part does not match the one (10k) provided in your BOM. Please confirm; | C25804 | https://jlcpcb.com/partdetail/26547-0603WAF1002T5E/C25804 | Basic | 46 | 46 JLCPCB | 0.1104
R6,R7 |  | 5.1k | 0603 |  | Unconfirmed | 0603WAF5101T5E | UNI-ROYAL(Uniroyal Elec) | 0603 | -55℃~+155℃ 100mW 5.1kΩ 75V Thick Film Resistor ±1% ±100ppm/℃ 0603 Chip Resistor - Surface Mount ROHS | Chip Resistor - Surface Mount | 1.The comment (0603WAF5101T5E) of this part does not match the one (5.1k) provided in your BOM. Please confirm; | C23186 | https://jlcpcb.com/partdetail/23913-0603WAF5101T5E/C23186 | Basic | 20 | 20 JLCPCB | 0.056
 | R10,R11,R8,R9 | 33k | 0603 |  | Unconfirmed | 0603WAF3302T5E | UNI-ROYAL(Uniroyal Elec) | 0603 | -55℃~+155℃ 100mW 33kΩ 75V Thick Film Resistor ±1% ±100ppm/℃ 0603 Chip Resistor - Surface Mount ROHS | Chip Resistor - Surface Mount | 1.The comment (0603WAF3302T5E) of this part does not match the one (33k) provided in your BOM. Please confirm; | C4216 | https://jlcpcb.com/partdetail/4623-0603WAF3302T5E/C4216 | Basic | 20 | 20 JLCPCB | 0.042
R14 |  | 249k | 0603 |  | Unconfirmed | 0603WAF2493T5E | UNI-ROYAL(Uniroyal Elec) | 0603 | -55℃~+155℃ 100mW 249kΩ 75V Thick Film Resistor ±1% ±100ppm/℃ 0603 Chip Resistor - Surface Mount ROHS | Chip Resistor - Surface Mount | 1.The comment (0603WAF2493T5E) of this part does not match the one (249k) provided in your BOM. Please confirm; | C22918 | https://jlcpcb.com/partdetail/23645-0603WAF2493T5E/C22918 | Extended | 20 | 20 JLCPCB | 0.042
R16 |  | 13k | 0603 |  | Unconfirmed | 0603WAF1302T5E | UNI-ROYAL(Uniroyal Elec) | 0603 | -55℃~+155℃ 100mW 13kΩ 75V Thick Film Resistor ±1% ±100ppm/℃ 0603 Chip Resistor - Surface Mount ROHS | Chip Resistor - Surface Mount | 1.The comment (0603WAF1302T5E) of this part does not match the one (13k) provided in your BOM. Please confirm; | C22797 | https://jlcpcb.com/partdetail/23524-0603WAF1302T5E/C22797 | Basic | 20 | 20 JLCPCB | 0.122
R17 |  | 619 | 0603 |  | Unconfirmed | FRC0603F6190TS | FOJAN | 0603 | -55℃~+155℃ 100mW 619Ω 75V Thick Film Resistor ±1% ±100ppm/℃ 0603 Chip Resistor - Surface Mount ROHS | Chip Resistor - Surface Mount | 1.The comment (FRC0603F6190TS) of this part does not match the one (619) provided in your BOM. Please confirm; | C3013204 | https://jlcpcb.com/partdetail/FOJAN-FRC0603F6190TS/C3013204 | Extended | 20 | 20 JLCPCB | 0.048
R18 |  | 22k | 0603 |  | Unconfirmed | 0603WAF2202T5E | UNI-ROYAL(Uniroyal Elec) | 0603 | -55℃~+155℃ 100mW 22kΩ 75V Thick Film Resistor ±1% ±100ppm/℃ 0603 Chip Resistor - Surface Mount ROHS | Chip Resistor - Surface Mount | 1.The comment (0603WAF2202T5E) of this part does not match the one (22k) provided in your BOM. Please confirm; | C31850 | https://jlcpcb.com/partdetail/32812-0603WAF2202T5E/C31850 | Basic | 20 | 20 JLCPCB | 0.048
R19 |  | 150 | 0603 |  | Unconfirmed | 0603WAF1500T5E | UNI-ROYAL(Uniroyal Elec) | 0603 | -55℃~+155℃ 100mW 150Ω 75V Thick Film Resistor ±1% ±100ppm/℃ 0603 Chip Resistor - Surface Mount ROHS | Chip Resistor - Surface Mount | 1.The comment (0603WAF1500T5E) of this part does not match the one (150) provided in your BOM. Please confirm; | C22808 | https://jlcpcb.com/partdetail/23535-0603WAF1500T5E/C22808 | Basic | 20 | 20 JLCPCB | 0.216
R20 |  | 120 | 0603 |  | Unconfirmed | 0603WAF1200T5E | UNI-ROYAL(Uniroyal Elec) | 0603 | -55℃~+155℃ 100mW 120Ω 75V Thick Film Resistor ±1% ±100ppm/℃ 0603 Chip Resistor - Surface Mount ROHS | Chip Resistor - Surface Mount | 1.The comment (0603WAF1200T5E) of this part does not match the one (120) provided in your BOM. Please confirm; | C22787 | https://jlcpcb.com/partdetail/23514-0603WAF1200T5E/C22787 | Basic | 20 | 20 JLCPCB | 0.054
 | R31,R49 | 4.99k | 0603 |  | Unconfirmed | 0603WAF4991T5E | UNI-ROYAL(Uniroyal Elec) | 0603 | -55℃~+155℃ 100mW 4.99kΩ 75V Thick Film Resistor ±1% ±100ppm/℃ 0603 Chip Resistor - Surface Mount ROHS | Chip Resistor - Surface Mount | 1.The comment (0603WAF4991T5E) of this part does not match the one (4.99k) provided in your BOM. Please confirm; | C23046 | https://jlcpcb.com/partdetail/23773-0603WAF4991T5E/C23046 | Basic | 20 | 20 JLCPCB | 0.182
R34 |  | 50k | 0603 |  | Unconfirmed | RT0603BRD0750KL | YAGEO | 0603 | -55℃~+155℃ 100mW 50kΩ 75V Thin Film Resistor ±0.1% ±25ppm/℃ 0603 Chip Resistor - Surface Mount ROHS | Chip Resistor - Surface Mount | 1.The comment (RT0603BRD0750KL) of this part does not match the one (50k) provided in your BOM. Please confirm; | C861451 | https://jlcpcb.com/partdetail/YAGEO-RT0603BRD0750KL/C861451 | Extended | 20 | 20 JLCPCB | 0.648
 | R36 | 392k | 0603 |  | Unconfirmed | RCA03392KFLF | HKR(Hong Kong Resistors) | 0603 | -55℃~+155℃ 100mW 392kΩ 75V Thick Film Resistor ±1% ±100ppm/℃ 0603 Chip Resistor - Surface Mount ROHS |  | 1.The comment (RCA03392KFLF) of this part does not match the one (392k) provided in your BOM. Please confirm; | C22369707 | https://jlcpcb.com/partdetail/23848738-RCA03392KFLF/C22369707 | Extended | 20 | 20 JLCPCB | 0.03
R37,R38 |  | 2M | 0603 |  | Unconfirmed | 0603WAF2004T5E | UNI-ROYAL(Uniroyal Elec) | 0603 | -55℃~+155℃ 100mW 2MΩ 75V Thick Film Resistor ±1% ±100ppm/℃ 0603 Chip Resistor - Surface Mount ROHS | Chip Resistor - Surface Mount | 1.The comment (0603WAF2004T5E) of this part does not match the one (2M) provided in your BOM. Please confirm; | C22976 | https://jlcpcb.com/partdetail/23703-0603WAF2004T5E/C22976 | Basic | 20 | 20 JLCPCB | 0.056
R39 |  | 100k | 0603 |  | Unconfirmed | 0603WAF1003T5E | UNI-ROYAL(Uniroyal Elec) | 0603 | -55℃~+155℃ 100kΩ 100mW 75V Thick Film Resistor ±1% ±100ppm/℃ 0603 Chip Resistor - Surface Mount ROHS | Chip Resistor - Surface Mount | 1.The comment (0603WAF1003T5E) of this part does not match the one (100k) provided in your BOM. Please confirm; | C25803 | https://jlcpcb.com/partdetail/26546-0603WAF1003T5E/C25803 | Basic | 20 | 20 JLCPCB | 0.054
R47,R48 |  | 4.7k | 0603 |  | Unconfirmed | 0603WAF4701T5E | UNI-ROYAL(Uniroyal Elec) | 0603 | -55℃~+155℃ 100mW 4.7kΩ 75V Thick Film Resistor ±1% ±100ppm/℃ 0603 Chip Resistor - Surface Mount ROHS | Chip Resistor - Surface Mount | 1.The comment (0603WAF4701T5E) of this part does not match the one (4.7k) provided in your BOM. Please confirm; | C23162 | https://jlcpcb.com/partdetail/23889-0603WAF4701T5E/C23162 | Basic | 20 | 20 JLCPCB | 0.042
 | RN1,RN2,RN3,RN4 | R_Pack04_SIP_Split | 4D03WGF5101T5E |  | Select by Customer | 4D03WGF5101T5E | UNI-ROYAL(Uniroyal Elec) | 0603x4 | 1/16W 4 5.1kΩ 8 ±1% ±200ppm/℃ 0603x4 Resistor Networks, Arrays ROHS | Resistor Networks, Arrays |  | C425200 | https://jlcpcb.com/partdetail/418824-4D03WGF5101T5E/C425200 | Extended | 8 | 8 JLCPCB | 0.1008
SW1 |  | ON_SW | K3-1260D-L1 |  | Select by Customer | K3-1260D-L1 | Korean Hroparts Elec | 插件,9x3.5mm | -25℃~+80℃ 10000 times 3.5mm 3.5mm 300mA 6V 9mm Black PC Pin Rectangular Columnar SPDT 插件,9x3.5mm Slide Switches ROHS | Slide Switches | 1.Multiple lines in the BOM have been matched to the same part. Please check if the matching is correct. ; | C92657 | https://jlcpcb.com/partdetail/Korean_HropartsElec-K3_1260DL1/C92657 | Extended | 5 | 5 JLCPCB | 0.6655
SW2 |  | SEL_SW | K3-1260D-L1 |  | Select by Customer | K3-1260D-L1 | Korean Hroparts Elec | 插件,9x3.5mm | -25℃~+80℃ 10000 times 3.5mm 3.5mm 300mA 6V 9mm Black PC Pin Rectangular Columnar SPDT 插件,9x3.5mm Slide Switches ROHS | Slide Switches | 1.Multiple lines in the BOM have been matched to the same part. Please check if the matching is correct. ; | C92657 | https://jlcpcb.com/partdetail/Korean_HropartsElec-K3_1260DL1/C92657 | Extended | 5 | 5 JLCPCB | 0.6655
SW3 |  | RST_BTN | K2-1187SQ-A4SW-06 |  | Select by Customer | K2-1187SQ-A4SW-06 | Korean Hroparts Elec | SMD-4P,5.2x5.2mm | -25℃~+85℃ 1.5mm 100,000 cycles 12V 2.5N 5.2mm 5.2mm 50mA Round Button SPST Surface Mount,Vertical SMD-4P,5.2x5.2mm Tactile Switches ROHS | Tactile Switches |  | C92584 | https://jlcpcb.com/partdetail/Korean_HropartsElec-K2_1187SQ_A4SW06/C92584 | Extended | 2 | 2 JLCPCB | 0.108
 | U1 | ADS1299 | TQFP-64_10x10mm_P0.5mm |  | Unconfirmed | ADS1299IPAGR | Texas Instruments | TQFP-64(10x10) | -40℃~+85℃ 1.5MHz~2.048MHz、2.048MHz 121dB 16000Hz 16000Hz 20uA 24 4.5V 4.75V~5.25V 8 Programmable gain、Multiplexers、Internal reference source、Fault detection、Built-in temperature sensor、Simultaneous sampling control SPI TQFP-64(10x10) Analog Front End (AFE) ROHS | Analog Front End (AFE) | 1.The comment (ADS1299IPAGR) of this part does not match the one (ADS1299) provided in your BOM. Please confirm; | C476817 | https://jlcpcb.com/partdetail/TexasInstruments-ADS1299IPAGR/C476817 | Extended | 2 | 2 JLCPCB | 102.998
U3 |  | ESP32-S3-WROOM-1 | ESP32-S3-WROOM-1 |  | Unconfirmed | ESP32-S3-WROOM-1-N16R8 | Espressif Systems | SMD,25.5x18mm | -103.5dBm -40℃~+65℃ 2.4GHz 20.5dBm 355mA 3V~3.6V 95mA ESP32-S3R8 On-board PCB Antenna UART、SPI、I2C、GPIO、I2S、USB SMD,25.5x18mm WiFi Modules ROHS | WiFi Modules | 1.The comment (ESP32-S3-WROOM-1-N16R8) of this part does not match the one (ESP32-S3-WROOM-1) provided in your BOM. Please confirm; | C2913202 | https://jlcpcb.com/partdetail/3198300-ESP32_S3_WROOM_1N16R8/C2913202 | Extended | 2 | 2 JLCPCB | 10.9892
 | U4 | OPA376xxDBV | SOT-23-5 |  | Select by Customer | OPA376AIDBVR | Texas Instruments | SOT-23-5 | -40℃~+125℃ 0.2pA 0.2pA 1 2.2V~5.5V 260nV/℃ 2V/us 30mA 5.5MHz 5uV 7.5nV/√Hz@1kHz 760uA 76dB Rail-to-Rail Input, Rail-to-Rail Output SOT-23-5 Precision Op Amps ROHS | Precision Op Amps |  | C42134 | https://jlcpcb.com/partdetail/TexasInstruments-OPA376AIDBVR/C42134 | Extended | 2 | 2 JLCPCB | 3.9156
U7 |  | TPS610997YFFR | BGA6N40P3X2_122X88X62N |  | Select by System | TPS610997YFFR | Texas Instruments | DSBGA-6 | -40℃~+85℃ 1 1.1uA 300mA 5V 700mV~5.5V Boost Boost Built-in Fixed Yes DSBGA-6 DC-DC Converters ROHS | DC-DC Converters |  | C2072359 | https://jlcpcb.com/partdetail/TexasInstruments-TPS610997YFFR/C2072359 | Extended | 2 | 2 JLCPCB | 1.6824
U8 |  | TPS628438DRL | SOT-563 |  | Unconfirmed | TPS628438DRLR | Texas Instruments | SOT-563 | -40℃~+125℃ 1 1.8V~3.6V 275nA 5.5V 600mA Adjustable Positive Under Voltage Lockout、Over Current Protection、Over Temperature Protection、Soft Start、Enable SOT-563 DC-DC Converters ROHS | Voltage Regulators - Linear, Low Drop Out (LDO) Regulators | 1.The comment (TPS628438DRLR) of this part does not match the one (TPS628438DRL) provided in your BOM. Please confirm; | C38060243 | https://jlcpcb.com/partdetail/TexasInstruments-TPS628438DRLR/C38060243 | Extended | 2 | 2 JLCPCB | 2.2462
J1 |  | ConnElectrodes | PinHeader_2x10_P2.54mm_Vertical |  | No matches | No Part Selected
 | TP1 | REF_TEST | TestPoint_Pad_D1.5mm |  | No matches | No Part Selected
 | TP2 | GND_TEST | TestPoint_Pad_D1.5mm |  | No matches | No Part Selected
TP3 |  | 3V3_TEST | TestPoint_Pad_D1.5mm |  | No matches | No Part Selected
TP4 |  | 5V_TEST | TestPoint_Pad_D1.5mm |  | No matches | No Part Selected
