eric5512/FreeEEG/electronics/FreeEEG.kicad_pcb

## KiCad design electronics/FreeEEG.kicad_pcb (2026-10-01)

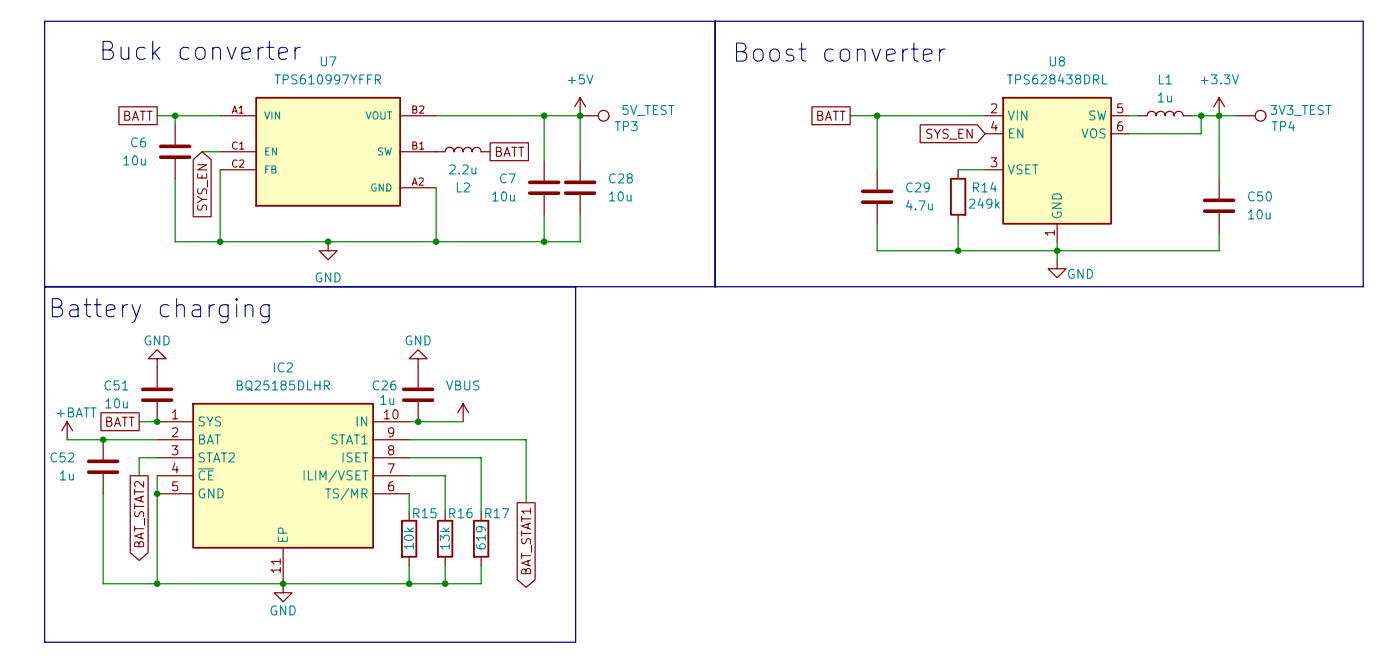
[picture p1: schematic power.kicad_sch]

Parts:
C6, C7, C28, C50, C51: 10u; C_0402_1005Metric
C26, C52: 1u; C_0402_1005Metric
C29: 4.7u; C_0402_1005Metric
IC2: BQ25185DLHR; SON40P220X200X80-11N; Manufacturer_Part_Number BQ25185DLHR; Mouser Part Number 595-BQ25185DLHR
L1: 1u; L_1008_2520Metric
L2: 2.2u; PIS2D18LP
R14: 249k; R_0603_1608Metric
R15: 10k; R_0603_1608Metric
R16: 13k; R_0603_1608Metric
R17: 619; R_0603_1608Metric
TP3: 5V_TEST; TestPoint_Pad_D1.5mm
TP4: 3V3_TEST; TestPoint_Pad_D1.5mm
U7: TPS610997YFFR; BGA6N40P3X2_122X88X62N; PARTREV K
U8: TPS628438DRL; SOT-563

Connections:
+3.3V: C50.1, L1.2, TP4.1 (1_1), U8.6 (VOS); also elsewhere on the board
+5V: C7.1, C28.1, TP3.1 (1_1), U7.B2 (VOUT); also elsewhere on the board
+BATT: C52.1, IC2.2 (BAT); also elsewhere on the board
BATT: C6.1, C29.1, C51.2, IC2.1 (SYS), L2.1, U7.A1 (VIN), U8.2 (VIN); also elsewhere on the board
BAT_STAT1: IC2.9 (STAT1); also elsewhere on the board
BAT_STAT2: IC2.3 (STAT2); also elsewhere on the board
GND: C6.2, C7.2, C26.1, C28.2, C29.2, C50.2, C51.1, C52.2, IC2.4 (~CE), IC2.5 (GND), IC2.11 (EP), R14.2, R15.2, R16.2, R17.2, U7.A2 (GND), U7.C2 (FB), U8.1 (GND); also elsewhere on the board
unnamed: IC2.7 (ILIM/VSET), R16.1
unnamed: IC2.8 (ISET), R17.1
unnamed: IC2.6 (TS/MR), R15.1
unnamed: L2.2, U7.B1 (SW)
unnamed: L1.1, U8.5 (SW)
unnamed: R14.1, U8.3 (VSET)
SYS_EN: U7.C1 (EN), U8.4 (EN); also elsewhere on the board
VBUS: C26.2, IC2.10 (IN); also elsewhere on the board

Notes on the sheet:
Battery charging
Buck converter
Boost converter

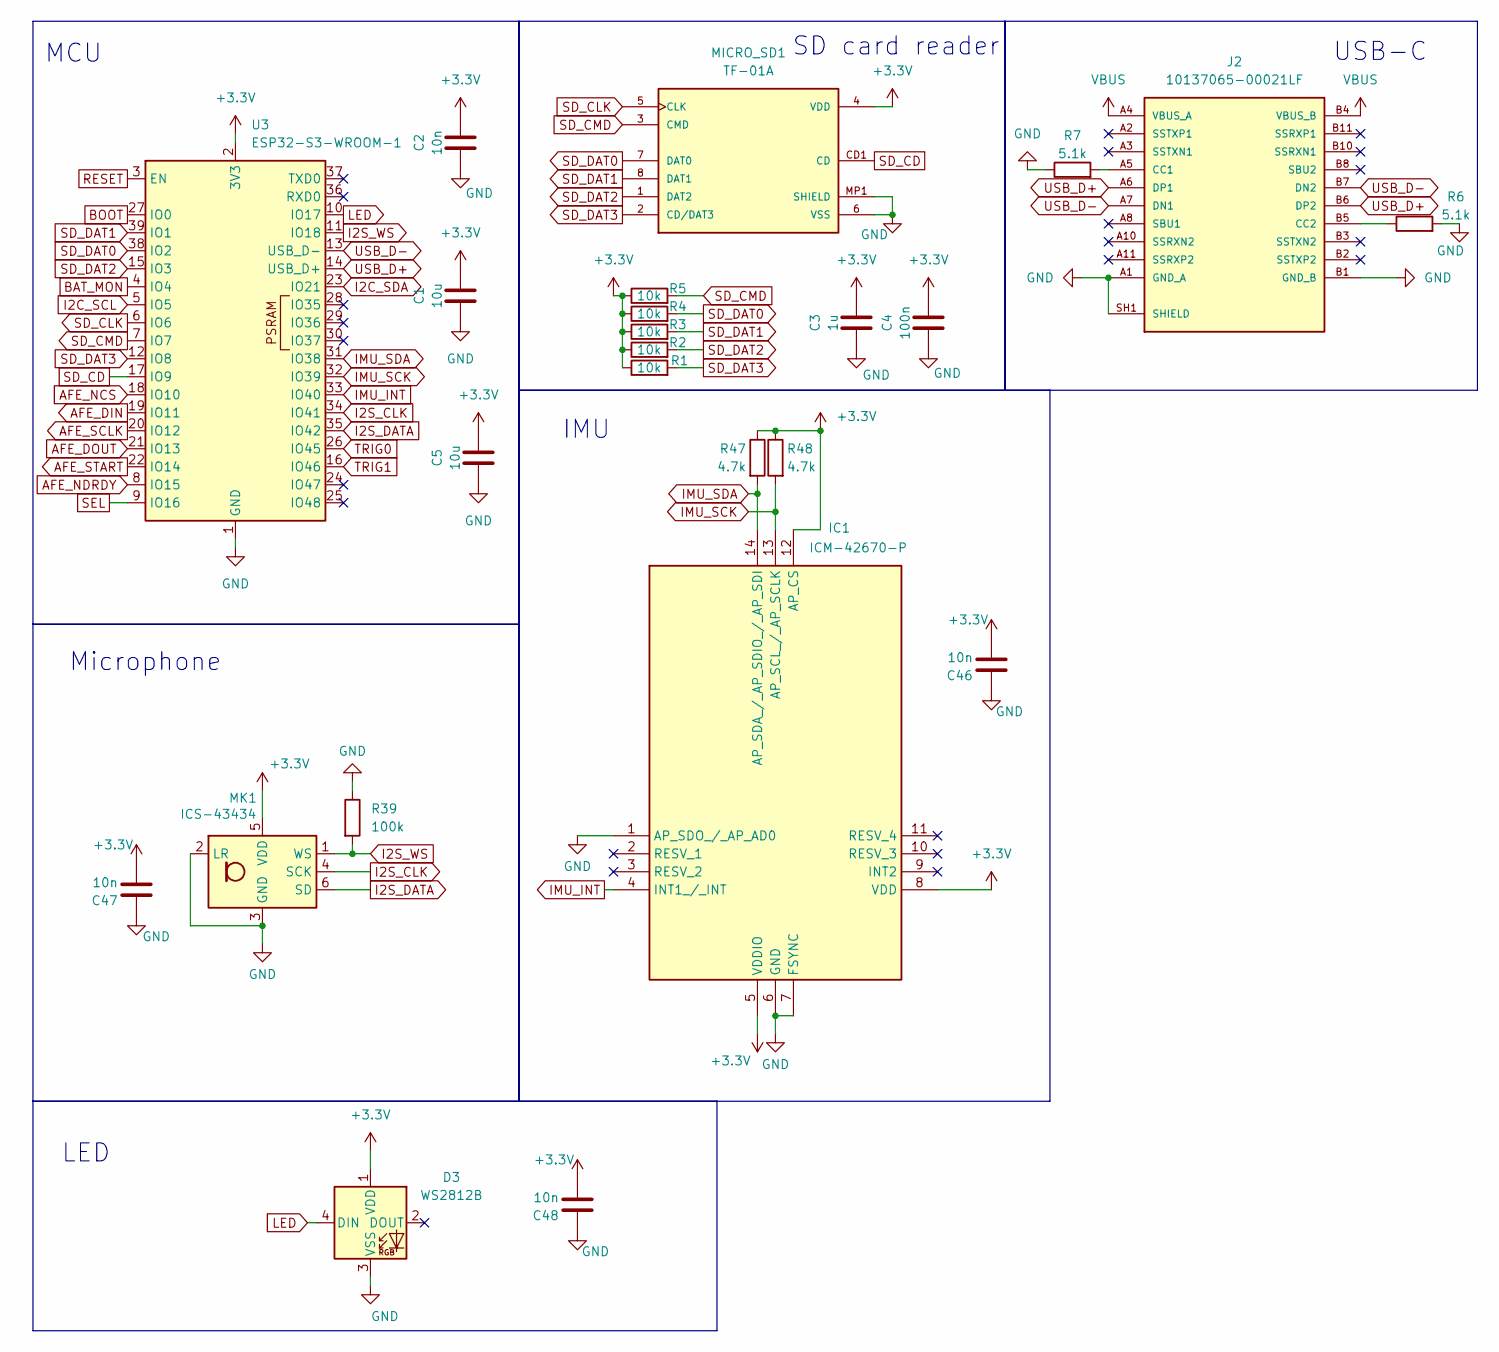
[picture p2: schematic digital.kicad_sch]

Parts:
C1, C5: 10u; C_0805_2012Metric
C2: 10n; C_0805_2012Metric
C3: 1u; C_0805_2012Metric
C4: 100n; C_0805_2012Metric
C46, C47, C48: 10n; C_0603_1608Metric
D3: WS2812B; LED_WS2812B_PLCC4_5.0x5.0mm_P3.2mm
IC1: ICM-42670-P; ICM42670P; Manufacturer_Part_Number ICM-42670-P; Mouser Part Number 410-ICM-42670-P
J2: 10137065-00021LF; AMPHENOL_10137065-00021LF; PARTREV D
MICRO_SD1: TF-01A
MK1: ICS-43434; ICS43434
R1, R2, R3, R4, R5: 10k; R_0603_1608Metric
R6, R7: 5.1k; R_0603_1608Metric
R39: 100k; R_0603_1608Metric
R47, R48: 4.7k; R_0603_1608Metric
U3: ESP32-S3-WROOM-1

Connections:
+3.3V: C1.2, C2.1, C3.2, C4.1, C5.2, C46.2, C47.2, C48.2, D3.1 (VDD), IC1.5 (VDDIO), IC1.8 (VDD), IC1.12 (AP_CS), MICRO_SD1.4 (VDD), MK1.5 (VDD), R1.1, R2.1, R3.1, R4.1, R5.1, R47.1, R48.1, U3.2 (3V3); also elsewhere on the board
AFE_DIN: U3.19 (IO11); also elsewhere on the board
AFE_DOUT: U3.21 (IO13); also elsewhere on the board
AFE_NCS: U3.18 (IO10); also elsewhere on the board
AFE_NDRDY: U3.8 (IO15); also elsewhere on the board
AFE_SCLK: U3.20 (IO12); also elsewhere on the board
AFE_START: U3.22 (IO14); also elsewhere on the board
BAT_MON: U3.4 (IO4); also elsewhere on the board
BOOT: U3.27 (IO0); also elsewhere on the board
GND: C1.1, C2.2, C3.1, C4.2, C5.1, C46.1, C47.1, C48.1, D3.3 (VSS), IC1.1 (AP_SDO_/_AP_AD0), IC1.6 (GND), IC1.7 (FSYNC), J2.A1 (GND_A), J2.A12 (GND_A), J2.B1 (GND_B), J2.B12 (GND_B), J2.SH1 (SHIELD), J2.SH2 (SHIELD), J2.SH3 (SHIELD), J2.SH4 (SHIELD), MICRO_SD1.6 (VSS), MICRO_SD1.MP1 (SHIELD), MICRO_SD1.MP2 (SHIELD), MICRO_SD1.MP3 (SHIELD), MICRO_SD1.MP4 (SHIELD), MK1.2 (LR), MK1.3 (GND), R6.2, R7.1, R39.1, U3.1 (GND), U3.40 (GND), U3.41 (GND); also elsewhere on the board
I2C_SCL: U3.5 (IO5); also elsewhere on the board
I2C_SDA: U3.23 (IO21); also elsewhere on the board
I2S_CLK: MK1.4 (SCK), U3.34 (IO41)
I2S_DATA: MK1.6 (SD), U3.35 (IO42)
I2S_WS: MK1.1 (WS), R39.2, U3.11 (IO18)
IMU_INT: IC1.4 (INT1_/_INT), U3.33 (IO40)
IMU_SCK: IC1.13 (AP_SCL_/_AP_SCLK), R48.2, U3.32 (IO39)
IMU_SDA: IC1.14 (AP_SDA_/_AP_SDIO_/_AP_SDI), R47.2, U3.31 (IO38)
LED: D3.4 (DIN), U3.10 (IO17)
unnamed: J2.A5 (CC1), R7.2
unnamed: J2.B5 (CC2), R6.1
RESET: U3.3 (EN); also elsewhere on the board
SD_CD: MICRO_SD1.CD1 (CD), U3.17 (IO9)
SD_CLK: MICRO_SD1.5 (CLK), U3.6 (IO6)
SD_CMD: MICRO_SD1.3 (CMD), R5.2, U3.7 (IO7)
SD_DAT0: MICRO_SD1.7 (DAT0), R4.2, U3.38 (IO2)
SD_DAT1: MICRO_SD1.8 (DAT1), R3.2, U3.39 (IO1)
SD_DAT2: MICRO_SD1.1 (DAT2), R2.2, U3.15 (IO3)
SD_DAT3: MICRO_SD1.2 (CD/DAT3), R1.2, U3.12 (IO8)
SEL: U3.9 (IO16); also elsewhere on the board
TRIG0: U3.26 (IO45); also elsewhere on the board
TRIG1: U3.16 (IO46); also elsewhere on the board
USB_D+: J2.A6 (DP1), J2.B6 (DP2), U3.14 (USB_D+)
USB_D-: J2.A7 (DN1), J2.B7 (DN2), U3.13 (USB_D-)
VBUS: J2.A4 (VBUS_A), J2.A9 (VBUS_A), J2.B4 (VBUS_B), J2.B9 (VBUS_B); also elsewhere on the board

Notes on the sheet:
MCU
IMU
SD card reader
Microphone
LED
USB-C

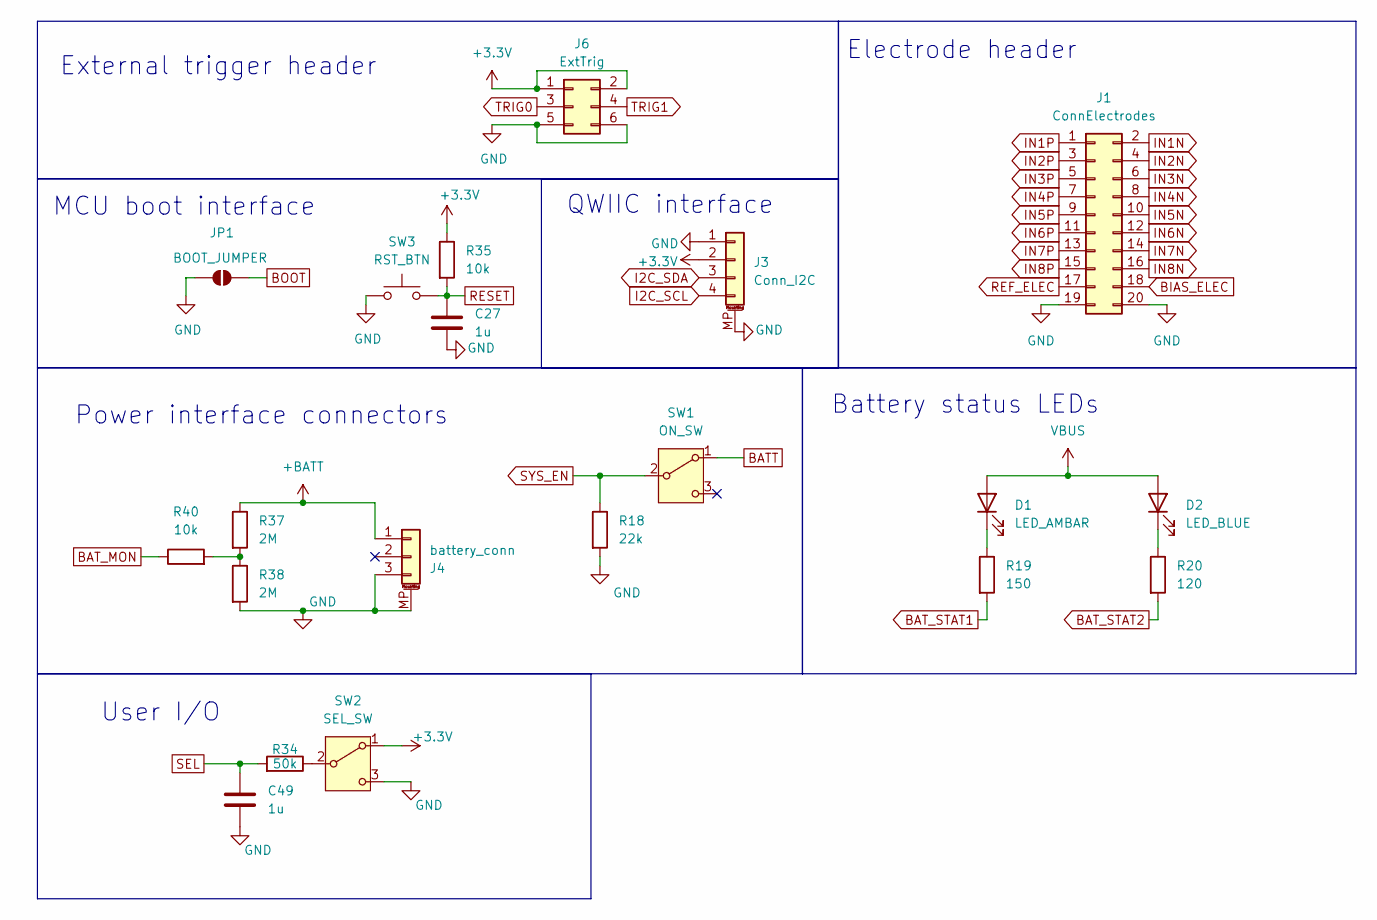
[picture p3: schematic interface.kicad_sch]

Parts:
C27: 1u; C_0805_2012Metric
C49: 1u; C_0603_1608Metric
D1: LED_AMBAR; LED_0603_1608Metric
D2: LED_BLUE; LED_0603_1608Metric
J1: ConnElectrodes; PinHeader_2x10_P2.54mm_Vertical
J3: Conn_I2C; JST_SH_SM04B-SRSS-TB_1x04-1MP_P1.00mm_Horizontal
J4: battery_conn; Molex_PicoBlade_53261-0371_1x03-1MP_P1.25mm_Horizontal
J6: ExtTrig; PinHeader_2x03_P2.54mm_Vertical_SMD; JLCPCB C192301
JP1: BOOT_JUMPER; SolderJumper-2_P1.3mm_Open_Pad1.0x1.5mm
R18: 22k; R_0603_1608Metric
R19: 150; R_0603_1608Metric
R20: 120; R_0603_1608Metric
R34: 50k; R_0603_1608Metric
R35, R40: 10k; R_0603_1608Metric
R37, R38: 2M; R_0603_1608Metric
SW1: ON_SW; K3-1260D-L1
SW2: SEL_SW; K3-1260D-L1
SW3: RST_BTN; K2-1187SQ-A4SW-06

Connections:
+3.3V: J3.2, J6.1, J6.2, R35.1, SW2.1 (A); also elsewhere on the board
+BATT: J4.1, R37.1; also elsewhere on the board
BATT: SW1.1 (A); also elsewhere on the board
BAT_MON: R40.1; also elsewhere on the board
BAT_STAT1: R19.2; also elsewhere on the board
BAT_STAT2: R20.2; also elsewhere on the board
BIAS_ELEC: J1.18; also elsewhere on the board
BOOT: JP1.2 (B); also elsewhere on the board
GND: C27.2, C49.2, J1.19, J1.20, J3.1, J3.MP (MountPin), J4.3, J4.MP (MountPin), J6.5, J6.6, JP1.1 (A), R18.2, R38.2, SW2.3 (C), SW3.1; also elsewhere on the board
I2C_SCL: J3.4; also elsewhere on the board
I2C_SDA: J3.3; also elsewhere on the board
IN1N: J1.2; also elsewhere on the board
IN1P: J1.1; also elsewhere on the board
IN2N: J1.4; also elsewhere on the board
IN2P: J1.3; also elsewhere on the board
IN3N: J1.6; also elsewhere on the board
IN3P: J1.5; also elsewhere on the board
IN4N: J1.8; also elsewhere on the board
IN4P: J1.7; also elsewhere on the board
IN5N: J1.10; also elsewhere on the board
IN5P: J1.9; also elsewhere on the board
IN6N: J1.12; also elsewhere on the board
IN6P: J1.11; also elsewhere on the board
IN7N: J1.14; also elsewhere on the board
IN7P: J1.13; also elsewhere on the board
IN8N: J1.16; also elsewhere on the board
IN8P: J1.15; also elsewhere on the board
unnamed: D1.1 (K), R19.1
unnamed: D2.1 (K), R20.1
unnamed: R37.2, R38.1, R40.2
unnamed: R34.1, SW2.2 (B)
REF_ELEC: J1.17; also elsewhere on the board
RESET: C27.1, R35.2, SW3.2; also elsewhere on the board
SEL: C49.1, R34.2; also elsewhere on the board
SYS_EN: R18.1, SW1.2 (B); also elsewhere on the board
TRIG0: J6.3; also elsewhere on the board
TRIG1: J6.4; also elsewhere on the board
VBUS: D1.2 (A), D2.2 (A); also elsewhere on the board

Notes on the sheet:
MCU boot interface
User I/O
QWIIC interface
Battery status LEDs
External trigger header
Power interface connectors
Electrode header

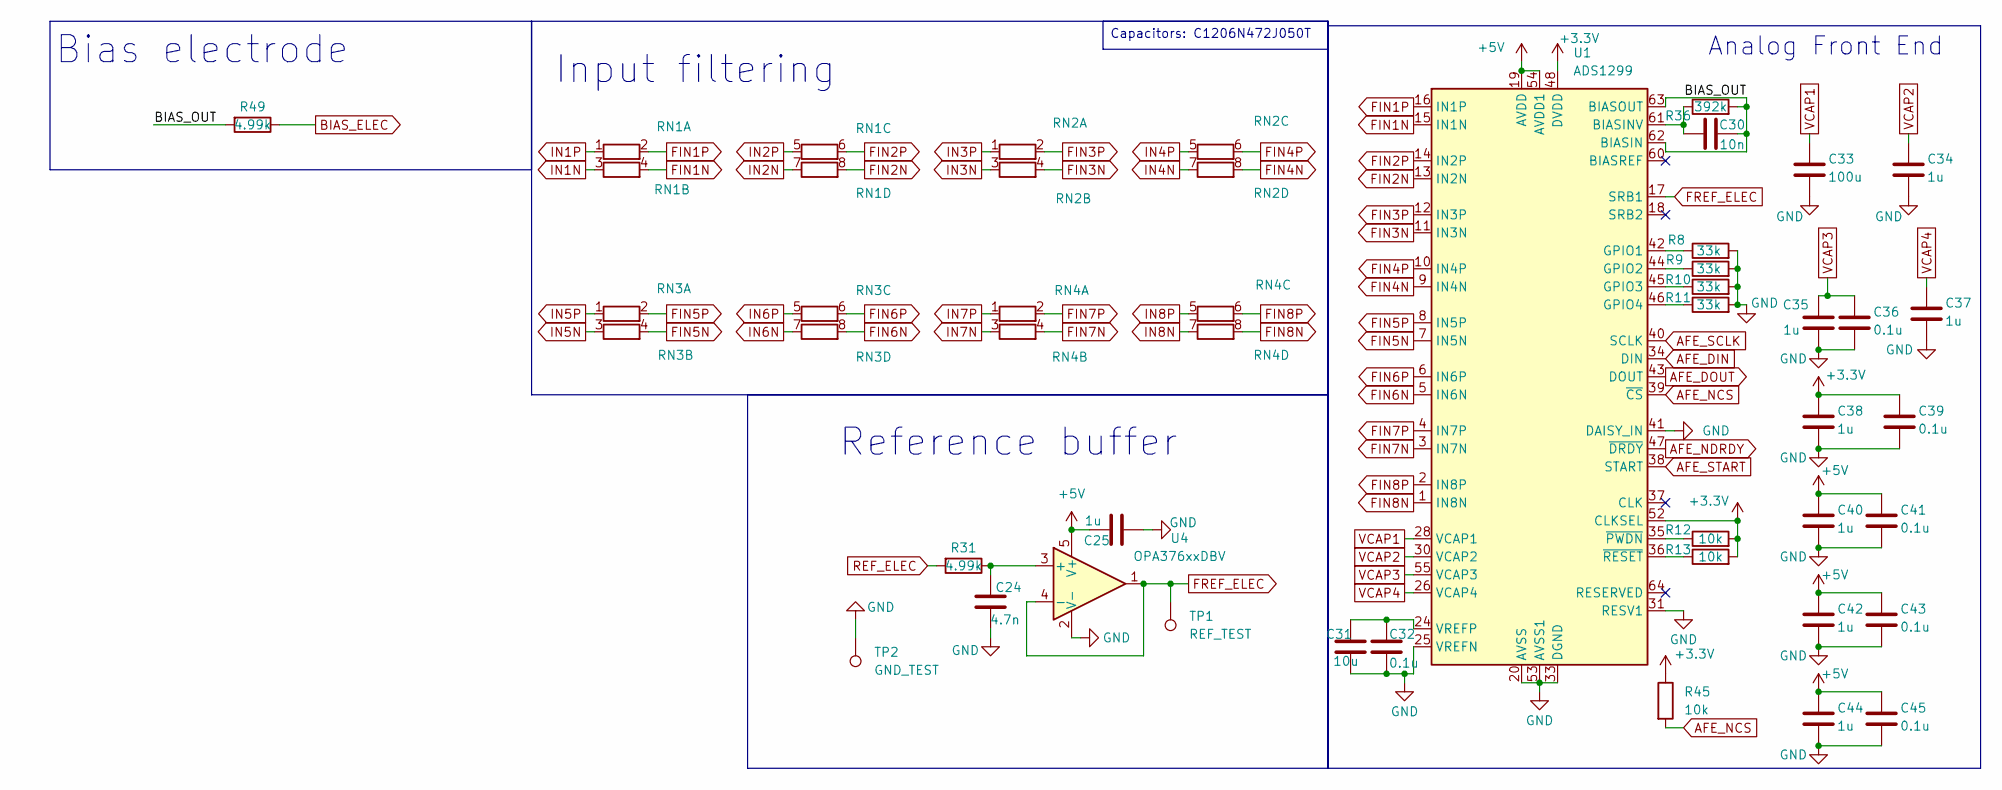
[picture p4: schematic analog.kicad_sch]

Parts:
C24: 4.7n; C_0603_1608Metric
C25: 1u; C_0805_2012Metric
C30: 10n; C_0603_1608Metric
C31: 10u; C_0805_2012Metric
C32, C36, C39, C41, C43, C45: 0.1u; C_0603_1608Metric
C33: 100u; C_1206_3216Metric
C34, C35, C37, C38, C40, C42, C44: 1u; C_0603_1608Metric
R8, R9, R10, R11: 33k; R_0603_1608Metric
R12, R13, R45: 10k; R_0603_1608Metric
R31, R49: 4.99k; R_0603_1608Metric
R36: 392k; R_0603_1608Metric
RN1, RN2, RN3, RN4: R_Pack04_SIP_Split; 4D03WGF5101T5E
TP1: REF_TEST; TestPoint_Pad_D1.5mm
TP2: GND_TEST; TestPoint_Pad_D1.5mm
U1: ADS1299; TQFP-64_10x10mm_P0.5mm
U4: OPA376xxDBV; SOT-23-5

Connections:
+3.3V: C38.1, C39.1, R12.2, R13.2, R45.1, U1.48 (DVDD), U1.50 (DVDD), U1.52 (CLKSEL); also elsewhere on the board
+5V: C25.2, C40.1, C41.1, C42.1, C43.1, C44.1, C45.1, U1.19 (AVDD), U1.21 (AVDD), U1.22 (AVDD), U1.54 (AVDD1), U1.56 (AVDD), U1.59 (AVDD), U4.5 (V+); also elsewhere on the board
/Analog/BIAS_OUT: C30.2, R36.2, R49.2, U1.62 (BIASIN), U1.63 (BIASOUT)
AFE_DIN: U1.34 (DIN); also elsewhere on the board
AFE_DOUT: U1.43 (DOUT); also elsewhere on the board
AFE_NCS: R45.2, U1.39 (~CS); also elsewhere on the board
AFE_NDRDY: U1.47 (~DRDY); also elsewhere on the board
AFE_SCLK: U1.40 (SCLK); also elsewhere on the board
AFE_START: U1.38 (START); also elsewhere on the board
BIAS_ELEC: R49.1; also elsewhere on the board
FIN1N: RN1.4 (R2.2), U1.15 (IN1N)
FIN1P: RN1.2 (R1.2), U1.16 (IN1P)
FIN2N: RN1.8 (R4.2), U1.13 (IN2N)
FIN2P: RN1.6 (R3.2), U1.14 (IN2P)
FIN3N: RN2.4 (R2.2), U1.11 (IN3N)
FIN3P: RN2.2 (R1.2), U1.12 (IN3P)
FIN4N: RN2.8 (R4.2), U1.9 (IN4N)
FIN4P: RN2.6 (R3.2), U1.10 (IN4P)
FIN5N: RN3.4 (R2.2), U1.7 (IN5N)
FIN5P: RN3.2 (R1.2), U1.8 (IN5P)
FIN6N: RN3.8 (R4.2), U1.5 (IN6N)
FIN6P: RN3.6 (R3.2), U1.6 (IN6P)
FIN7N: RN4.4 (R2.2), U1.3 (IN7N)
FIN7P: RN4.2 (R1.2), U1.4 (IN7P)
FIN8N: RN4.8 (R4.2), U1.1 (IN8N)
FIN8P: RN4.6 (R3.2), U1.2 (IN8P)
FREF_ELEC: TP1.1 (1_1), U1.17 (SRB1), U4.1, U4.4 (-)
GND: C24.2, C25.1, C31.2, C32.2, C33.2, C34.2, C35.2, C36.2, C37.2, C38.2, C39.2, C40.2, C41.2, C42.2, C43.2, C44.2, C45.2, R8.2, R9.2, R10.2, R11.2, TP2.1 (1_1), U1.20 (AVSS), U1.23 (AVSS), U1.25 (VREFN), U1.31 (RESV1), U1.32 (AVSS), U1.33 (DGND), U1.41 (DAISY_IN), U1.49 (DGND), U1.51 (DGND), U1.53 (AVSS1), U1.57 (AVSS), U1.58 (AVSS), U4.2 (V-); also elsewhere on the board
IN1N: RN1.3 (R2.1); also elsewhere on the board
IN1P: RN1.1 (R1.1); also elsewhere on the board
IN2N: RN1.7 (R4.1); also elsewhere on the board
IN2P: RN1.5 (R3.1); also elsewhere on the board
IN3N: RN2.3 (R2.1); also elsewhere on the board
IN3P: RN2.1 (R1.1); also elsewhere on the board
IN4N: RN2.7 (R4.1); also elsewhere on the board
IN4P: RN2.5 (R3.1); also elsewhere on the board
IN5N: RN3.3 (R2.1); also elsewhere on the board
IN5P: RN3.1 (R1.1); also elsewhere on the board
IN6N: RN3.7 (R4.1); also elsewhere on the board
IN6P: RN3.5 (R3.1); also elsewhere on the board
IN7N: RN4.3 (R2.1); also elsewhere on the board
IN7P: RN4.1 (R1.1); also elsewhere on the board
IN8N: RN4.7 (R4.1); also elsewhere on the board
IN8P: RN4.5 (R3.1); also elsewhere on the board
unnamed: C30.1, R36.1, U1.61 (BIASINV)
unnamed: R8.1, U1.42 (GPIO1)
unnamed: R9.1, U1.44 (GPIO2)
unnamed: R10.1, U1.45 (GPIO3)
unnamed: R11.1, U1.46 (GPIO4)
unnamed: C31.1, C32.1, U1.24 (VREFP)
unnamed: R12.1, U1.35 (~PWDN)
unnamed: R13.1, U1.36 (~RESET)
unnamed: C24.1, R31.1, U4.3 (+)
REF_ELEC: R31.2; also elsewhere on the board
VCAP1: C33.1, U1.28 (VCAP1)
VCAP2: C34.1, U1.30 (VCAP2)
VCAP3: C35.1, C36.1, U1.55 (VCAP3)
VCAP4: C37.1, U1.26 (VCAP4)

Notes on the sheet:
Reference buffer
Input filtering
Analog Front End
Bias electrode
Capacitors: C1206N472J050T

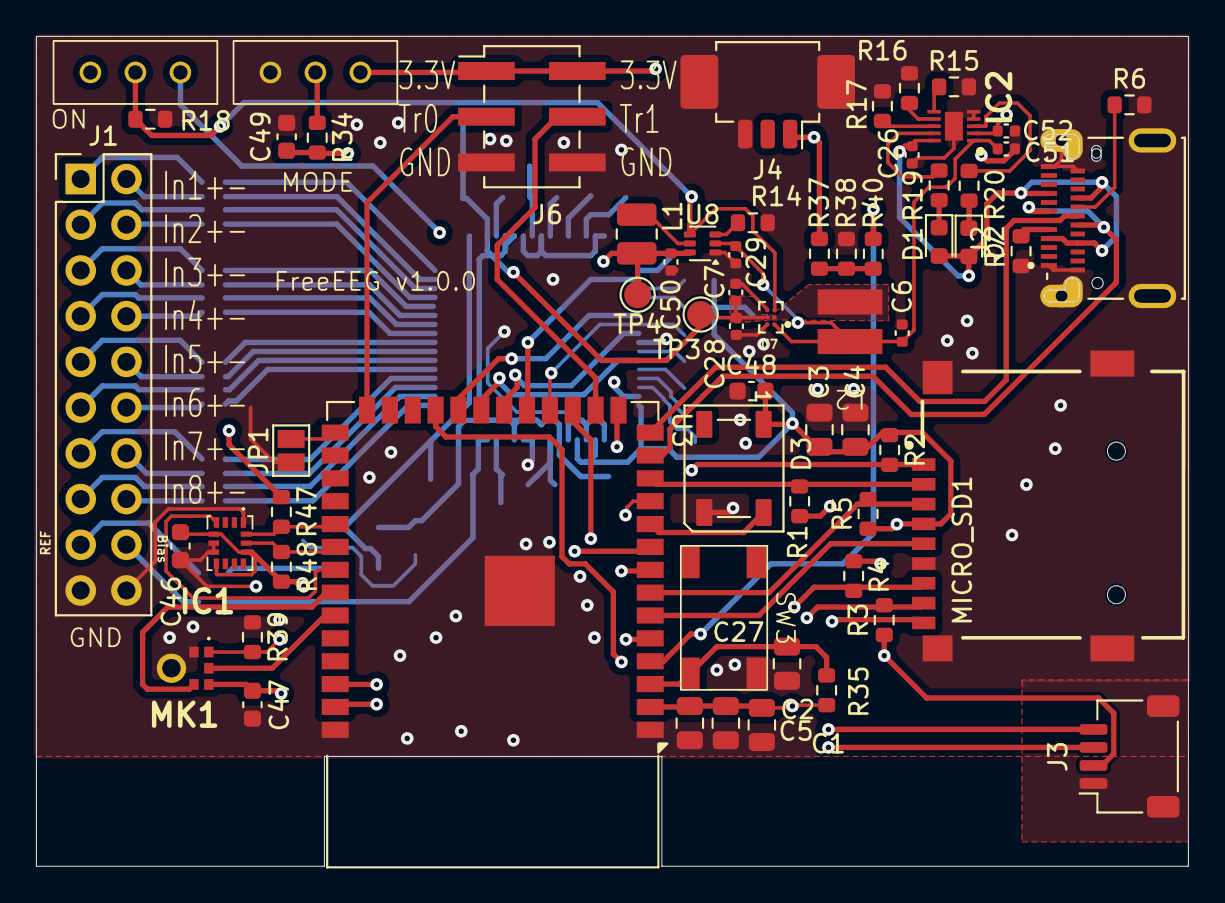
[picture p5: board FreeEEG.kicad_pcb from above]

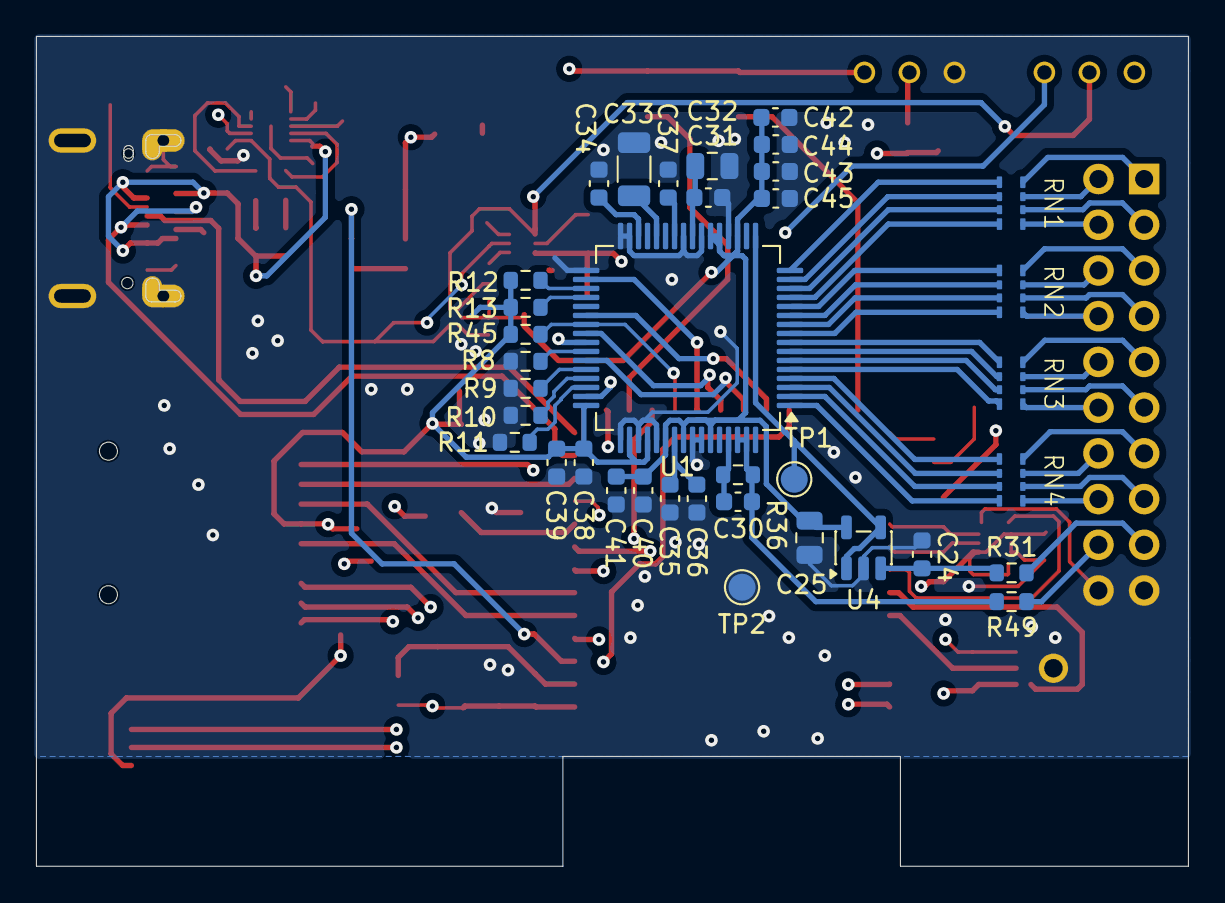
[picture p6: board FreeEEG.kicad_pcb from below]

Board: 4 copper layers, 64.0 x 46.1 mm, 99 parts (36 on the bottom side), 100 nets.
