eric5512/FreeEEG/Firmware/main/include/index.html.h

unsigned char net_index_html[] = {
  0x3c, 0x74, 0x69, 0x74, 0x6c, 0x65, 0x3e, 0x43, 0x6f, 0x6e, 0x66, 0x69,
  0x67, 0x75, 0x72, 0x61, 0x74, 0x69, 0x6f, 0x6e, 0x3c, 0x2f, 0x74, 0x69,
  0x74, 0x6c, 0x65, 0x3e, 0x0a, 0x3c, 0x68, 0x31, 0x3e, 0x43, 0x6f, 0x6e,
  0x66, 0x69, 0x67, 0x75, 0x72, 0x61, 0x74, 0x69, 0x6f, 0x6e, 0x20, 0x70,
  0x61, 0x67, 0x65, 0x3c, 0x2f, 0x68, 0x31, 0x3e, 0x0a, 0x0a, 0x3c, 0x66,
  0x6f, 0x72, 0x6d, 0x20, 0x61, 0x63, 0x74, 0x69, 0x6f, 0x6e, 0x3d, 0x22,
  0x2f, 0x75, 0x70, 0x64, 0x61, 0x74, 0x65, 0x5f, 0x63, 0x6f, 0x6e, 0x66,
  0x69, 0x67, 0x22, 0x20, 0x6d, 0x65, 0x74, 0x68, 0x6f, 0x64, 0x3d, 0x22,
  0x70, 0x6f, 0x73, 0x74, 0x22, 0x3e, 0x0a, 0x20, 0x20, 0x3c, 0x68, 0x32,
  0x3e, 0x47, 0x65, 0x6e, 0x65, 0x72, 0x61, 0x6c, 0x20, 0x63, 0x6f, 0x6e,
  0x66, 0x69, 0x67, 0x75, 0x72, 0x61, 0x74, 0x69, 0x6f, 0x6e, 0x3c, 0x2f,
  0x68, 0x32, 0x3e, 0x0a, 0x0a, 0x20, 0x20, 0x3c, 0x70, 0x3e, 0x4e, 0x6f,
  0x74, 0x63, 0x68, 0x20, 0x66, 0x69, 0x6c, 0x74, 0x65, 0x72, 0x20, 0x66,
  0x72, 0x65, 0x71, 0x75, 0x65, 0x6e, 0x63, 0x79, 0x3a, 0x3c, 0x2f, 0x70,
  0x3e, 0x0a, 0x20, 0x20, 0x3c, 0x69, 0x6e, 0x70, 0x75, 0x74, 0x20, 0x74,
  0x79, 0x70, 0x65, 0x3d, 0x22, 0x72, 0x61, 0x64, 0x69, 0x6f, 0x22, 0x20,
  0x69, 0x64, 0x3d, 0x22, 0x66, 0x69, 0x6c, 0x74, 0x5f, 0x35, 0x30, 0x22,
  0x20, 0x6e, 0x61, 0x6d, 0x65, 0x3d, 0x22, 0x66, 0x69, 0x6c, 0x74, 0x5f,
  0x66, 0x72, 0x65, 0x71, 0x22, 0x20, 0x76, 0x61, 0x6c, 0x75, 0x65, 0x3d,
  0x22, 0x35, 0x30, 0x22, 0x20, 0x63, 0x68, 0x65, 0x63, 0x6b, 0x65, 0x64,
  0x3e, 0x0a, 0x20, 0x20, 0x3c, 0x6c, 0x61, 0x62, 0x65, 0x6c, 0x20, 0x66,
  0x6f, 0x72, 0x3d, 0x22, 0x66, 0x69, 0x6c, 0x74, 0x5f, 0x35, 0x30, 0x22,
  0x3e, 0x35, 0x30, 0x20, 0x48, 0x7a, 0x3c, 0x2f, 0x6c, 0x61, 0x62, 0x65,
  0x6c, 0x3e, 0x3c, 0x62, 0x72, 0x3e, 0x0a, 0x0a, 0x20, 0x20, 0x3c, 0x69,
  0x6e, 0x70, 0x75, 0x74, 0x20, 0x74, 0x79, 0x70, 0x65, 0x3d, 0x22, 0x72,
  0x61, 0x64, 0x69, 0x6f, 0x22, 0x20, 0x69, 0x64, 0x3d, 0x22, 0x66, 0x69,
  0x6c, 0x74, 0x5f, 0x36, 0x30, 0x22, 0x20, 0x6e, 0x61, 0x6d, 0x65, 0x3d,
  0x22, 0x66, 0x69, 0x6c, 0x74, 0x5f, 0x66, 0x72, 0x65, 0x71, 0x22, 0x20,
  0x76, 0x61, 0x6c, 0x75, 0x65, 0x3d, 0x22, 0x36, 0x30, 0x22, 0x3e, 0x0a,
  0x20, 0x20, 0x3c, 0x6c, 0x61, 0x62, 0x65, 0x6c, 0x20, 0x66, 0x6f, 0x72,
  0x3d, 0x22, 0x66, 0x69, 0x6c, 0x74, 0x5f, 0x36, 0x30, 0x22, 0x3e, 0x36,
  0x30, 0x20, 0x48, 0x7a, 0x3c, 0x2f, 0x6c, 0x61, 0x62, 0x65, 0x6c, 0x3e,
  0x3c, 0x62, 0x72, 0x3e, 0x0a, 0x0a, 0x20, 0x20, 0x3c, 0x62, 0x72, 0x3e,
  0x0a, 0x0a, 0x20, 0x20, 0x3c, 0x6c, 0x61, 0x62, 0x65, 0x6c, 0x20, 0x66,
  0x6f, 0x72, 0x3d, 0x22, 0x73, 0x61, 0x6d, 0x70, 0x6c, 0x65, 0x5f, 0x72,
  0x61, 0x74, 0x65, 0x22, 0x3e, 0x53, 0x61, 0x6d, 0x70, 0x6c, 0x69, 0x6e,
  0x67, 0x20, 0x72, 0x61, 0x74, 0x65, 0x3a, 0x3c, 0x2f, 0x6c, 0x61, 0x62,
  0x65, 0x6c, 0x3e, 0x0a, 0x20, 0x20, 0x3c, 0x73, 0x65, 0x6c, 0x65, 0x63,
  0x74, 0x20, 0x6e, 0x61, 0x6d, 0x65, 0x3d, 0x22, 0x73, 0x61, 0x6d, 0x70,
  0x6c, 0x65, 0x5f, 0x72, 0x61, 0x74, 0x65, 0x22, 0x20, 0x69, 0x64, 0x3d,
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
};
unsigned int net_index_html_len = 8333;
