eric5512/FreeEEG/(commit log)

2025-09-11 Working on front end
    Started developing:
    - ESP8266 web server and UDP data transmission
    - Python library for data reception + Matplotlib animation
    [FreeEEG.kicad_pcb, FreeEEG.kicad_sch]
2026-03-18 Changing packet organization
    [FreeEEG.kicad_sch]
2026-05-08 Starting final firmware development
    [FreeEEG.kicad_pcb, FreeEEG.kicad_sch, bom.xls]
2026-05-11 Added driver for ADS1299 and added wifi app files
2026-06-02 Solving the timing issues in the firmware and adding a decent README.md
    [ads1299.c, tasks.c, wifi_app.h]
2026-07-24 New board release and adding support for ws2812 LED
2026-09-16 [Electronics] version 1.0.0 of the PCB released.\n [Firmware] Added ICS43434 drivers and prepared code for reestructuration
2026-10-01 [Electronics] v1.0.0 of the board released. [Firmware] Separating code into components and adding tests
